renata7zemanova/Semafor/text/text/zkratky.tex

\cleardoublepage
\chapter*{\listofabbrevname}
\phantomsection
\addcontentsline{toc}{chapter}{\listofabbrevname}

\begin{acronym}[KolikMista]

	\acro{AD}{Analog to Digital - analogově-digitální}
	\acro{dB}{decibel - jednotka intenzity zvuku}
	\acro{DPS}{Deska plošného spoje}
	\acro{EMC}{Elektromagnetická kompatibilita}
	\acro{FDM}{Fused deposition modeling -  metoda 3D tisku pomocí taveného nanášení}
	\acro{GND}{Ground - nulový potenciál}
	\acro{GPIO}{General Purpose Input/Output - vstupně-výstupní piny}
	\acro{HTML}{Hyper Text Markup Language - hypertextový znakovací jazyk, který se používá pro vytváření webových stránek}
	\acro{IoT}{Internet of Things - internet věcí}
	\acro{IP}{Internet Protocol - internetový protokol}
	\acro{$I^2C$}{Inter-Integrated Circuit - multi-masterová sériová komunikační sběrnice}
	\acro{LED}{Light-Emitting Diode - dioda emitující světlo}
	\acro{LoRa}{Long Range Radio}
	\acro{LoRaWAN}{Long Range Wide Area Network}
	\acro{MCU}{Mikrokontrolér}
	\acro{NFC}{Near Field Communication - typ bezdrátové komunikace}
	\acro{PETG}{Polyethylentereftalát-glykol - materiál pro 3D tisk}
	\acro{RF}{Rádiová frekvence}
	\acro{ROM}{Read-Only Memory - typ elektronické paměti}
	\acro{SLA}{Stereolitografie - metoda 3D tisku}
	\acro{SPI}{Serial Peripheral Interface - sériové komunikační periferní rozhraní}
	\acro{UART}{Universal asynchronous receiver-transmitter - komunikační sběrnice}
	\acro{USB}{Universal Serial Bus - univerzální komunikační sériová sběrnice}
	\acro{WiFi}{Wireless Fidelity}

	%\acro{zkDummy}
	%	[KolikMista]
	%	{pouze ukázka vyhrazeného místa}

	%\acro{symfvz}						% název
	%	[\ensuremath{f_\textind{vz}}] % symbol
	%	{vzorkovací kmitočet}					% popis

\end{acronym}
