renata7zemanova/Semafor/text/sablona-obhaj.pdf

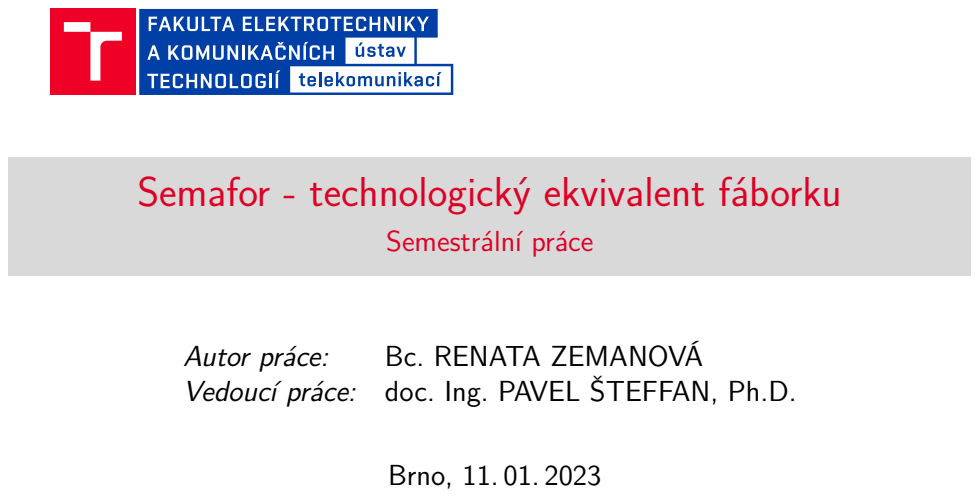
[picture p62: page 1]
Semestrální práce; Autor práce:; Bc. RENATA ZEMANOVÁ; Brno, 11. 01. 2023

Semafor - technologický ekvivalent fáborku

Vedoucí práce: doc. Ing. PAVEL ŠTEFFAN, Ph.D.

## Základní informace

Co je to Semafor?
Outdoorová aplikace
Edukační účely, táborové hry Zástupná funkce organizátora Dotykové senzory
Světelné a zvukové signalizace

Požadavky:
Kompaktnost
Bezpečnost
Široké využití

Voděodolnost
Nízkou cenu
Jednoduchost
Možnost komunikace mezi
jednotlivými Semafory
Bezdrátová konfigurovatelnost
Bc. Renata Zemanová | Semafor - technologický ekvivalent fáborku | 1 / 8

## Cíle práce

Nastudovat
Porovnat
Vybrat
Navrhnout


Bc. Renata Zemanová | Semafor - technologický ekvivalent fáborku | 2 / 8

## Základní prvky

Bezdrátová komunikace
LoRa
Dosah až 20 km
Bezlicenční pásmo
Topologie hvězdy
Obousměrná komunikace
WiFi
Bezlicenční pásmo
Rozšířená
V každém mobilním telefonu

Mikrokontrolér
ESP32-C3-MINI-1
WiFi s anténou
SPI, UART, I

2C, USB

13 GPIO pinů

Bc. Renata Zemanová | Semafor - technologický ekvivalent fáborku | 3 / 8

## Napájení

Baterie LiFePO4
3 až 3,6 V
Nejbezpečnější
Životnost až 7000 cyklů
Teplotně stabilní
Nehořlavé
Netoxické
Nabíjecí obvod CN3058E
Určený pro LiFePO4
Nastavitelný nabíjecí
proud
Signalizace stavu
nabíjení
Měření napětí na baterii

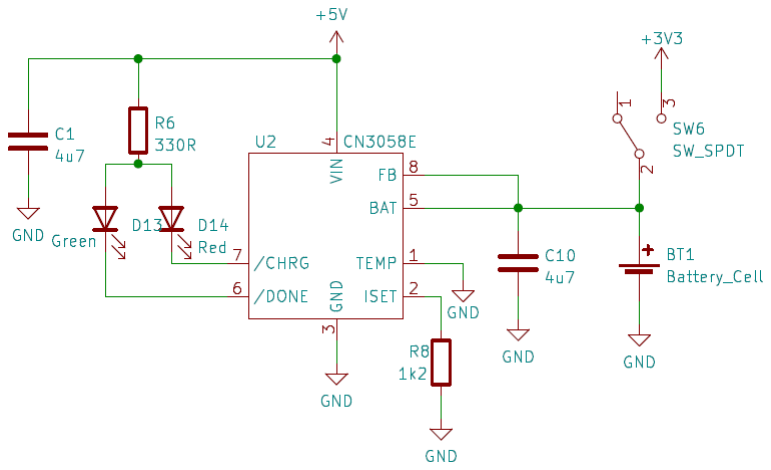
[picture p63: figure]

Bc. Renata Zemanová | Semafor - technologický ekvivalent fáborku | 4 / 8

## Komunikace s okolím

Světelná signalizace
Programovatelné LED WS2812C Možnost spojení za sebou
Převodník úrovní
Zvyšovač napětí LT1930

Senzory doteku
Kapacitní tlačítka
Mechanická odolnost
Životnost

Převodník
Komunikace po I

2C
Až 7 tlačítek

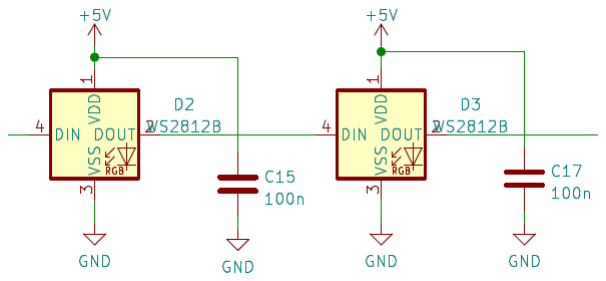
[picture p64: figure]

Bc. Renata Zemanová | Semafor - technologický ekvivalent fáborku | 5 / 8

## Budoucnost

Návrh DPS
Výroba a oživení DPS
Vytvoření her
Webová stránka pro konfiguraci
Bc. Renata Zemanová | Semafor - technologický ekvivalent fáborku | 6 / 8

## Závěr

Bezdrátový modul
Mikrokontrolér
Napájení
Senzory doteku
Signalizační prvky
Návrh kompletní
elektroniky

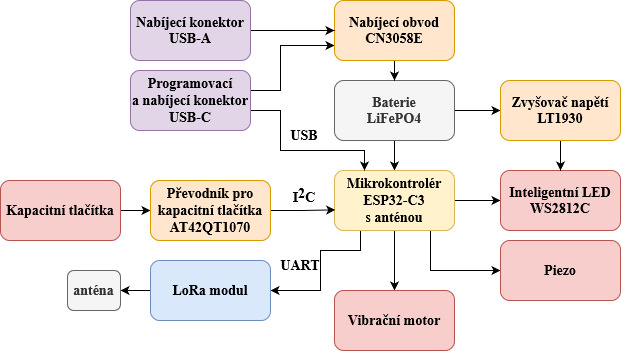
[picture p65: figure]

Bc. Renata Zemanová | Semafor - technologický ekvivalent fáborku | 7 / 8

# Děkuji za

# pozornost!

Bezdrátový modul
Mikrokontrolér
Napájení
Senzory doteku
Signalizační prvky
Návrh kompletní
elektroniky
Bc. Renata Zemanová | Semafor - technologický ekvivalent fáborku | 8 / 8
