renata7zemanova/Semafor/text/obrazky/tlacitka_princip.png

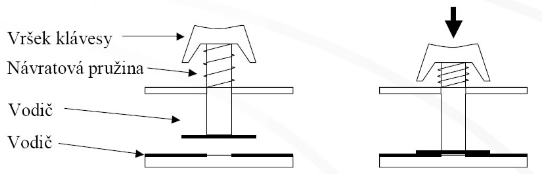
text/obrazky/tlacitka_princip.png
