renata7zemanova/Semafor/text/obrazky/vysledne_blokove_schema_priloha.jpg

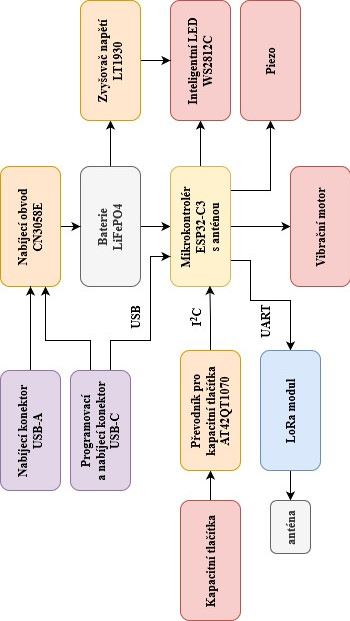
text/obrazky/vysledne_blokove_schema_priloha.jpg
