renata7zemanova/Semafor/forma_na_silikon/Semafor2_kompletni.SLDASM

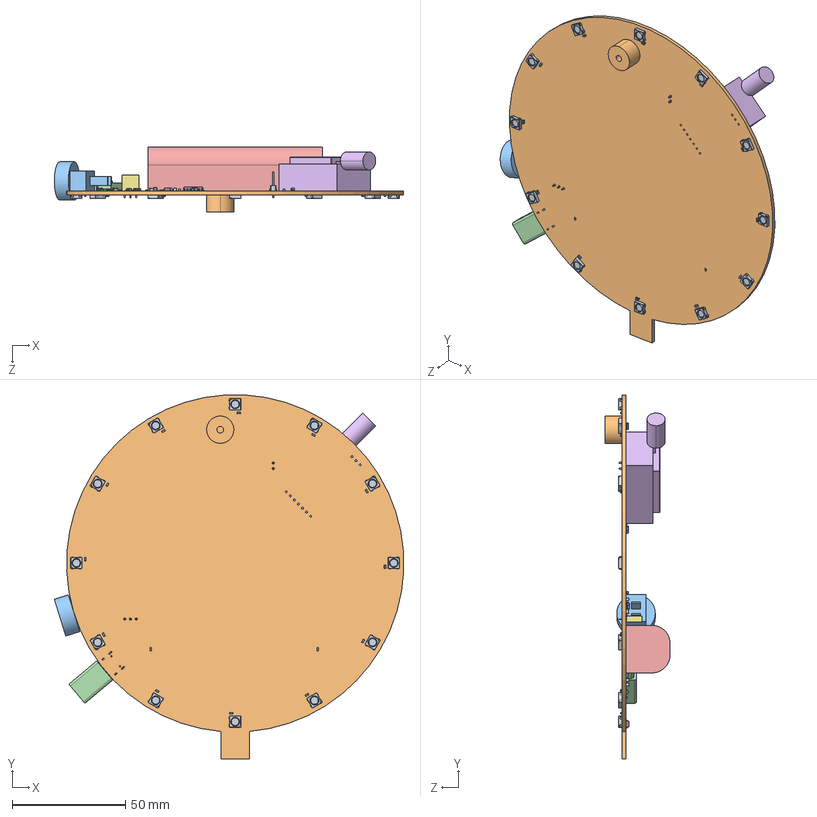
[picture p68: CAD file, 2023-05-05]
forma_na_silikon/Semafor2_kompletni.SLDASM
154.1 x 160.5 x 28.8 mm
SOLID.step x 12
SOLID-0.step
SOLID-1.step x 15
SOLID-2.step x 23
SOLID-3.step x 5
SOLID-4.step
SOLID-5.step
SOLID-6.step x 4
SOLID-7.step x 7
SOLID-8.step x 4
SOLID-9.step x 4
SOLID-10.step
SOLID-11.step
SOLID-12.step
SOLID-13.step x 2
SOLID-14.step
SOLID-15.step
Semafor PCB.step
Button
USB_cable
