renata7zemanova/Semafor/forma_na_silikon/Sestava_forma_Semafor_2.SLDASM

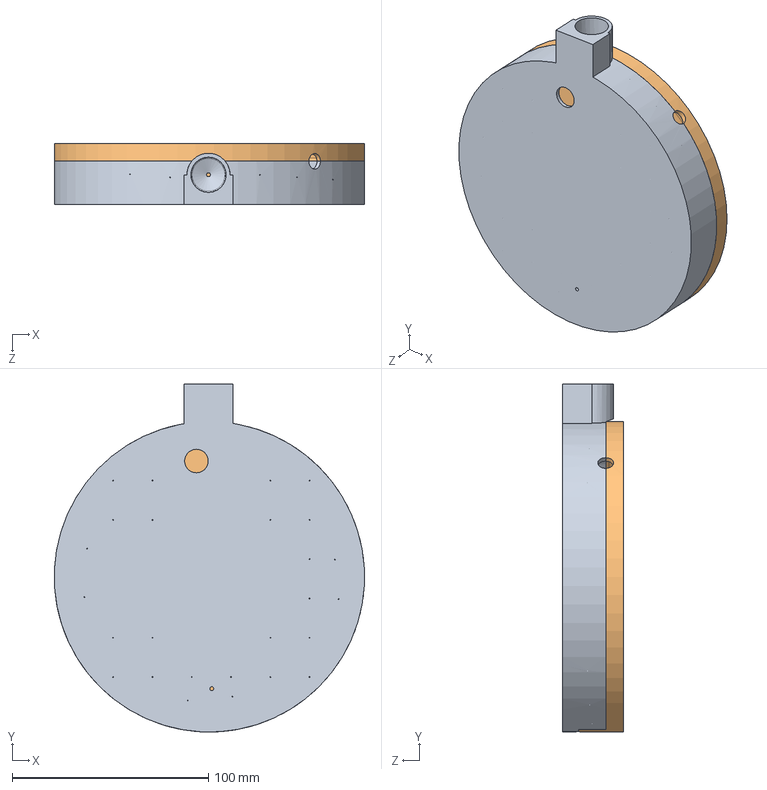
[picture p69: CAD file, 2023-05-05]
forma_na_silikon/Sestava_forma_Semafor_2.SLDASM
157.9 x 177.1 x 31.0 mm
Pulka_top_Semafor2
Pulka_bottom_Semafor2
