renata7zemanova/Semafor/forma_na_silikon/Semafor.SLDASM

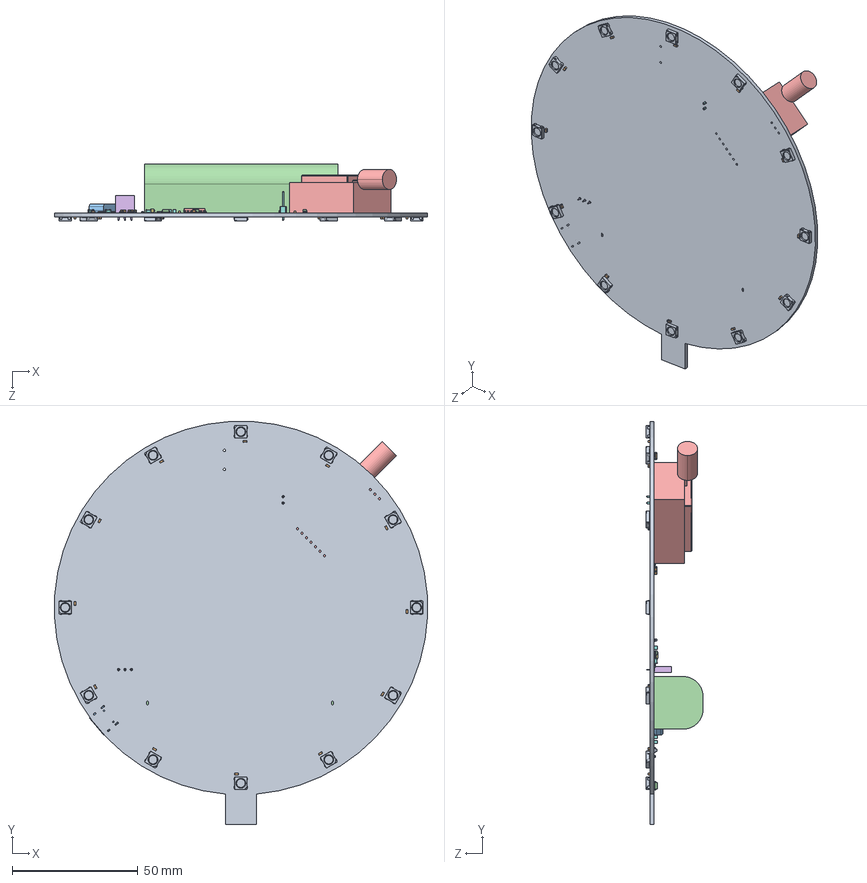
[picture p72: CAD file, 2023-05-05]
forma_na_silikon/Semafor.SLDASM
148.6 x 160.5 x 22.8 mm
SOLID.step x 12
SOLID-0.step x 15
SOLID-1.step x 23
SOLID-2.step x 5
SOLID-3.step
SOLID-4.step
SOLID-5.step x 4
SOLID-6.step x 7
SOLID-7.step x 4
SOLID-8.step x 4
SOLID-9.step
SOLID-10.step
SOLID-11.step
SOLID-12.step x 2
SOLID-13.step
SOLID-14.step
Semafor PCB.step
