renata7zemanova/Semafor/forma_na_silikon/Semafor2_s_obalem.SLDASM

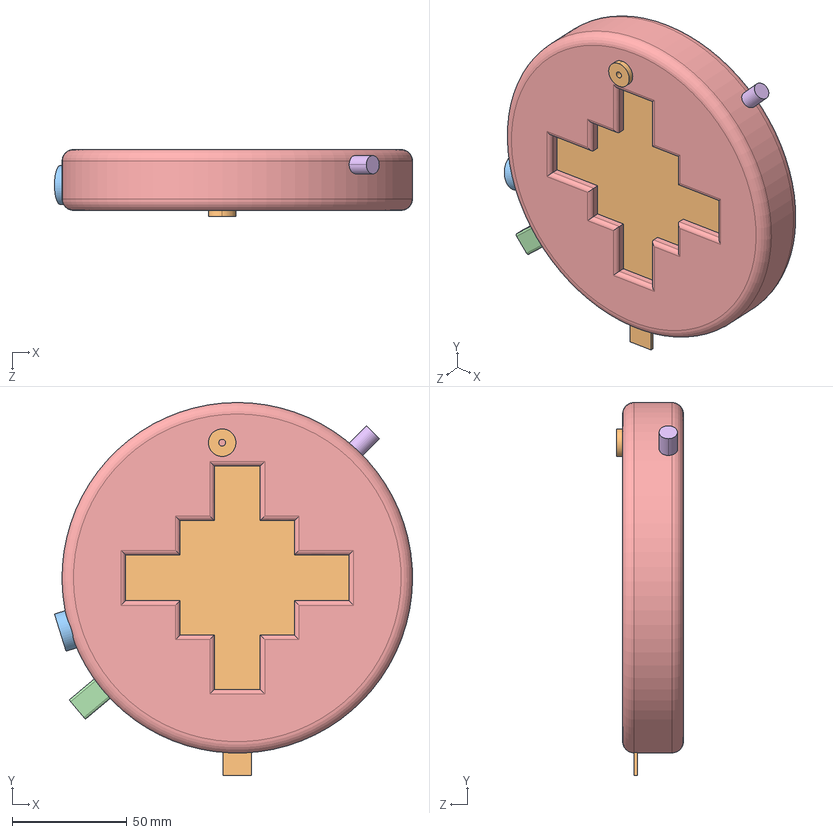
[picture p73: CAD file, 2023-05-05]
forma_na_silikon/Semafor2_s_obalem.SLDASM
156.3 x 162.8 x 29.2 mm
SOLID.step x 12
SOLID-0.step
SOLID-1.step x 15
SOLID-2.step x 23
SOLID-3.step x 5
SOLID-4.step
SOLID-5.step
SOLID-6.step x 4
SOLID-7.step x 7
SOLID-8.step x 4
SOLID-9.step x 4
SOLID-10.step
SOLID-11.step
SOLID-12.step
SOLID-13.step x 2
SOLID-14.step
SOLID-15.step
Semafor PCB.step
Button
USB_cable
Obal
