renata7zemanova/Semafor/forma_na_silikon/Forma_sestava.SLDASM

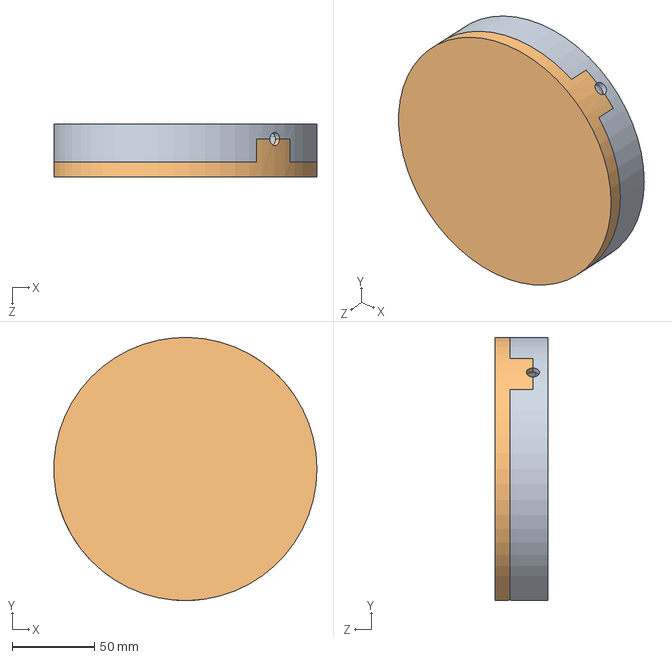
[picture p74: CAD file, 2023-05-05]
forma_na_silikon/Forma_sestava.SLDASM
159.9 x 159.9 x 32.0 mm
Pulka1
Pulka2
