renata7zemanova/Semafor/forma_na_silikon/Pulka_top_Semafor2.SLDPRT

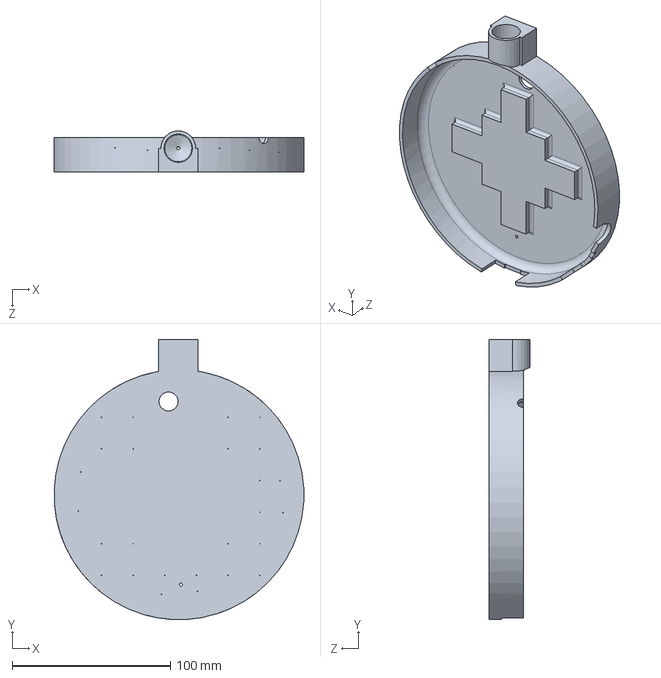
[picture p76: CAD file, 2023-05-05]
forma_na_silikon/Pulka_top_Semafor2.SLDPRT
157.8 x 177.0 x 26.0 mm
