renata7zemanova/Semafor/forma_na_silikon/soucastky/Vypinac.STEP

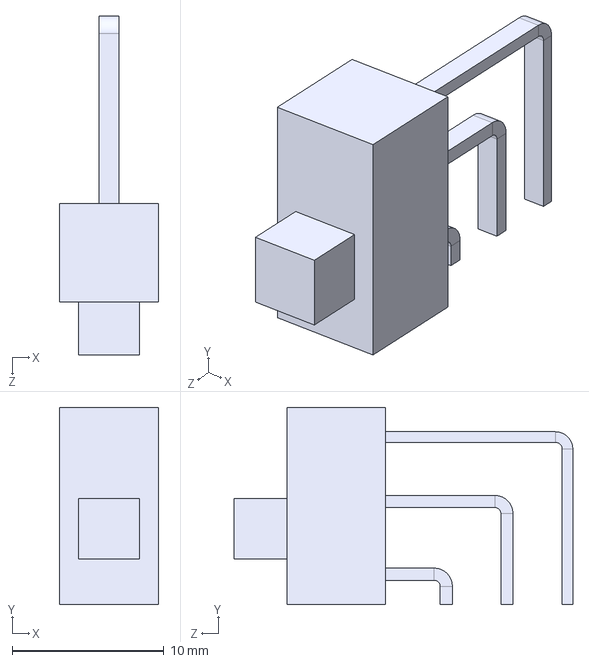
[picture p77: CAD file, 2023-05-07]
forma_na_silikon/soucastky/Vypinac.STEP
6.50 x 13.0 x 22.4 mm
