renata7zemanova/Semafor/obal/Krabicka_3D_tisk.SLDPRT

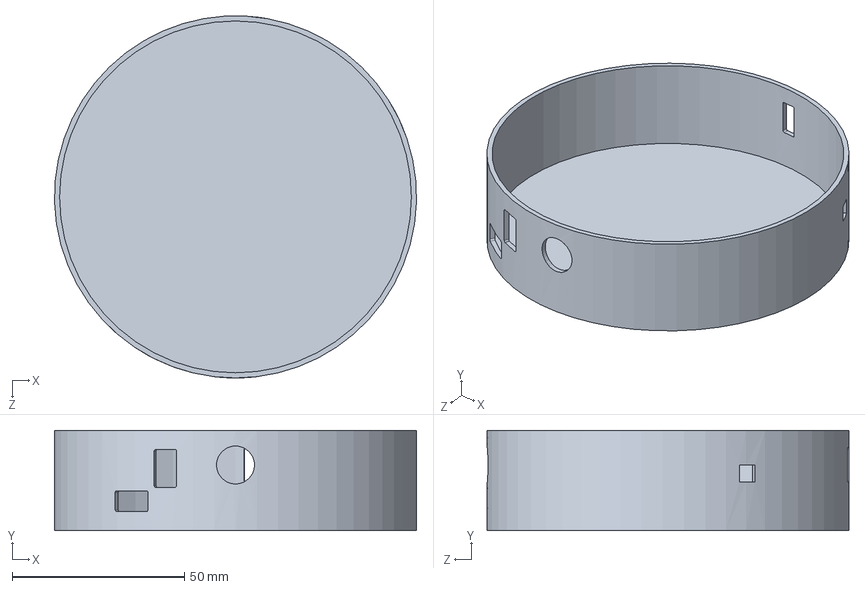
[picture p78: CAD file, 2023-05-15]
obal/Krabicka_3D_tisk.SLDPRT
105.0 x 29.0 x 104.9 mm
