renata7zemanova/Semafor/forma_na_silikon/Pulka2.SLDPRT

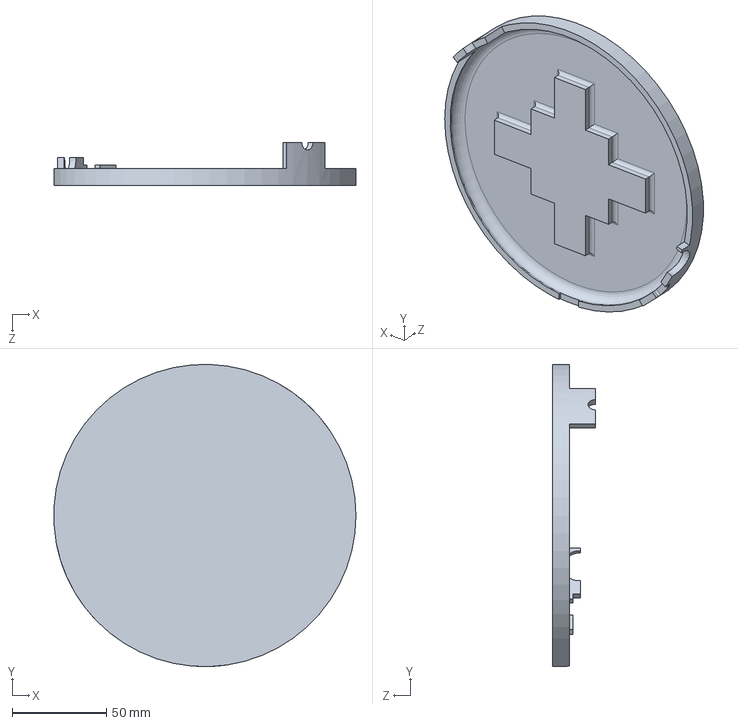
[picture p79: CAD file, 2023-05-05]
forma_na_silikon/Pulka2.SLDPRT
159.9 x 159.9 x 23.0 mm
