renata7zemanova/Semafor/forma_na_silikon/soucastky/Pinheady_dlouhe.STEP

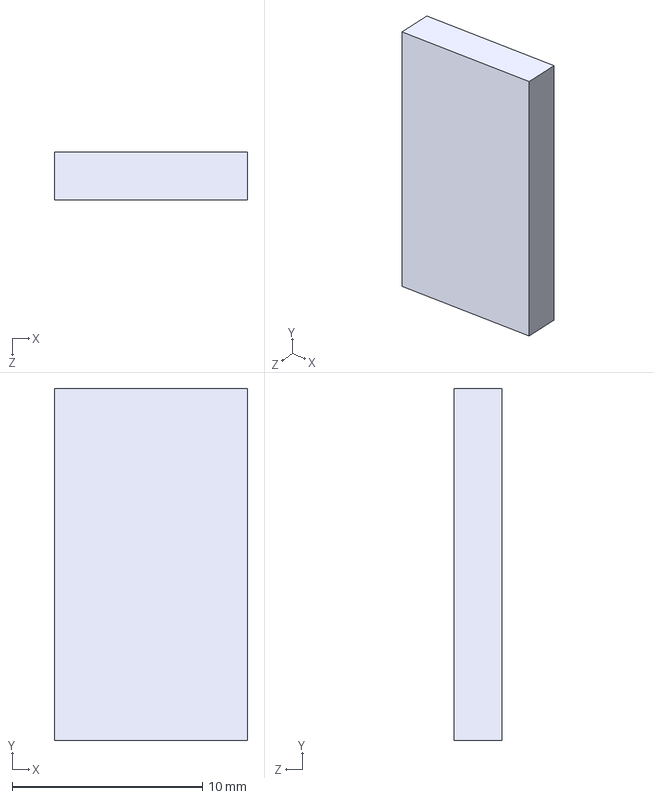
[picture p80: CAD file, 2023-05-05]
forma_na_silikon/soucastky/Pinheady_dlouhe.STEP
10.2 x 18.5 x 2.54 mm
