renata7zemanova/Semafor/obal/Na_tyblo.SLDPRT

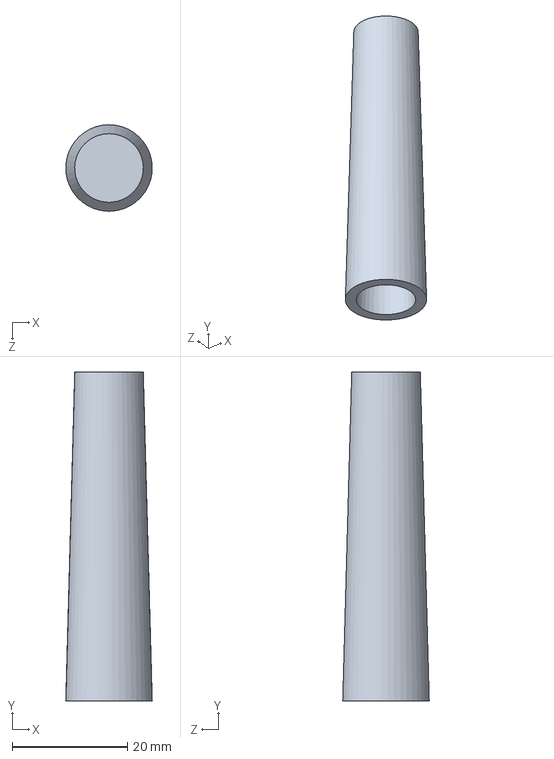
[picture p81: CAD file, 2023-05-15]
obal/Na_tyblo.SLDPRT
15.0 x 57.0 x 15.0 mm
