renata7zemanova/Semafor/forma_na_silikon/soucastky/USB_cable.SLDPRT

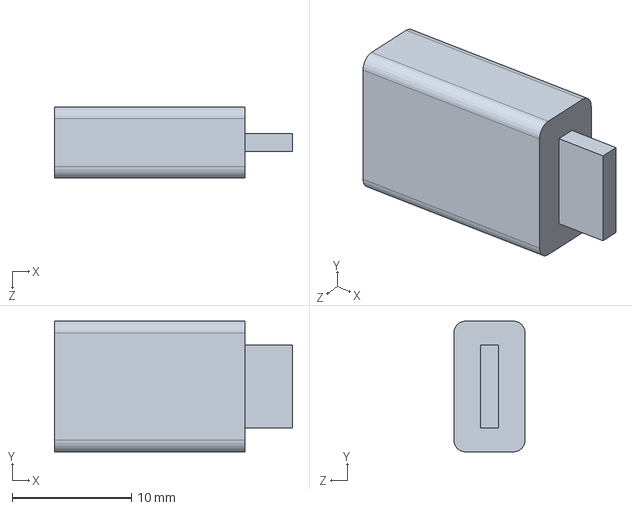
[picture p82: CAD file, 2023-05-05]
forma_na_silikon/soucastky/USB_cable.SLDPRT
20.0 x 11.0 x 6.00 mm
