renata7zemanova/Semafor/forma_na_silikon/Semafor_s_obalem_soucastka.SLDPRT

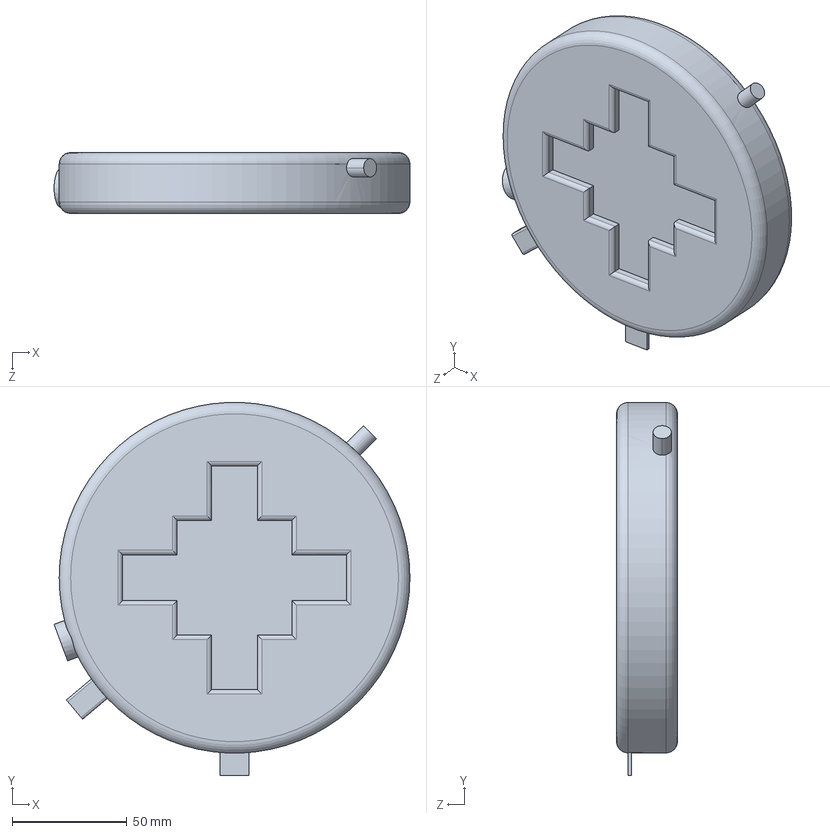
[picture p83: CAD file, 2023-05-05]
forma_na_silikon/Semafor_s_obalem_soucastka.SLDPRT
155.2 x 162.7 x 26.6 mm
