renata7zemanova/Semafor/forma_na_silikon/soucastky/Battery_pack.STEP

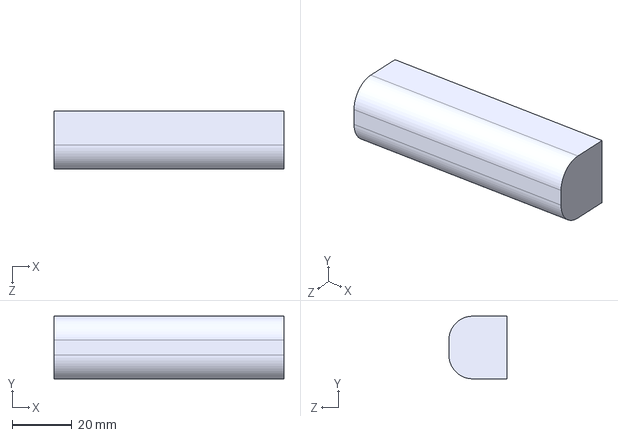
[picture p84: CAD file, 2023-05-05]
forma_na_silikon/soucastky/Battery_pack.STEP
77.0 x 21.0 x 19.5 mm
