renata7zemanova/Semafor/forma_na_silikon/Pulka_bottom_Semafor2.SLDPRT

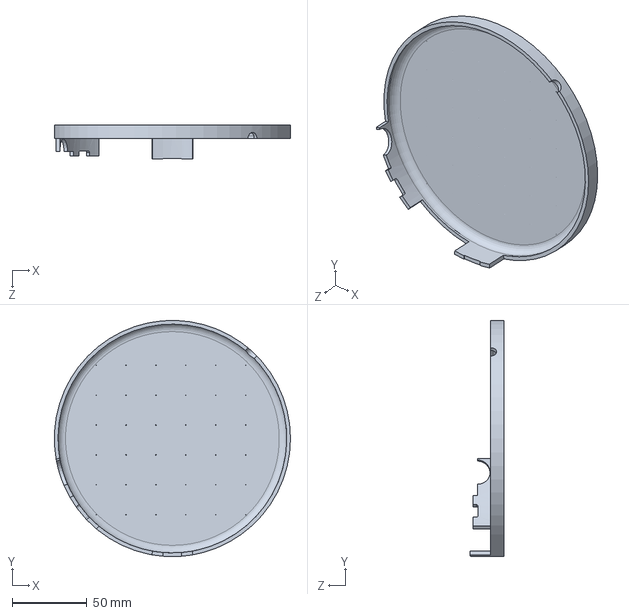
[picture p85: CAD file, 2023-05-05]
forma_na_silikon/Pulka_bottom_Semafor2.SLDPRT
157.9 x 157.9 x 23.0 mm
