renata7zemanova/Semafor/forma_na_silikon/soucastky/Button.SLDPRT

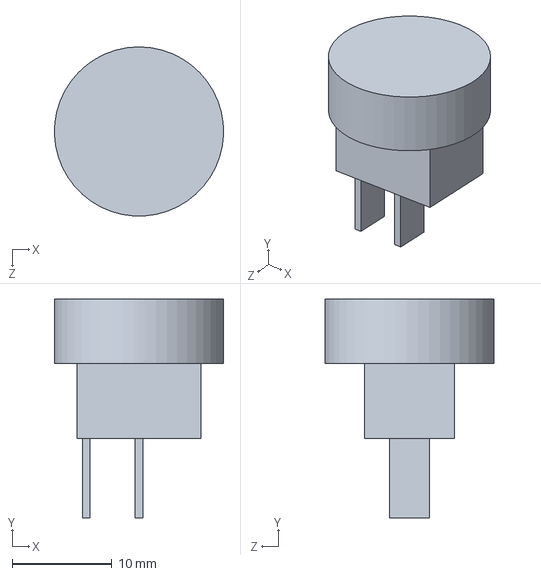
[picture p86: CAD file, 2023-05-05]
forma_na_silikon/soucastky/Button.SLDPRT
17.0 x 22.0 x 17.0 mm
