renata7zemanova/Semafor/forma_na_silikon/soucastky/E22_900T22D.STEP

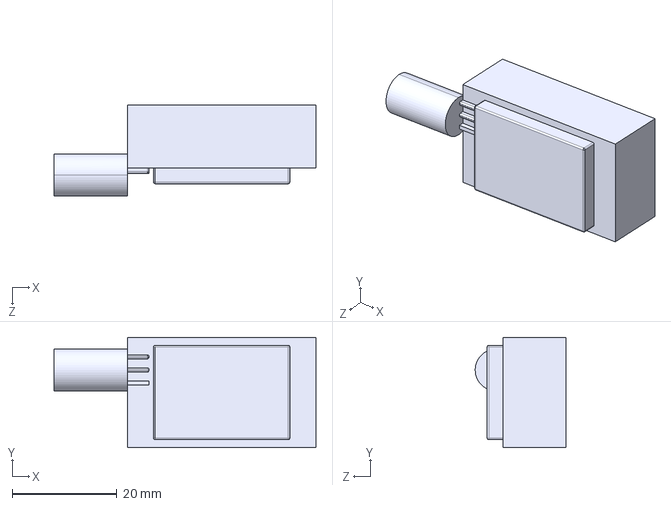
[picture p87: CAD file, 2023-05-05]
forma_na_silikon/soucastky/E22_900T22D.STEP
50.0 x 21.0 x 17.3 mm
