renata7zemanova/Semafor/forma_na_silikon/soucastky/USB_C.STEP

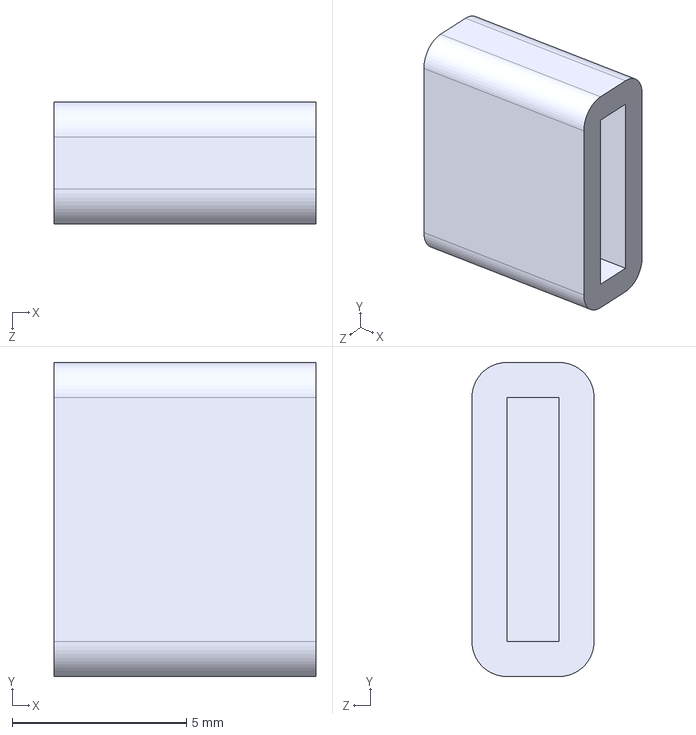
[picture p88: CAD file, 2023-05-05]
forma_na_silikon/soucastky/USB_C.STEP
7.50 x 9.00 x 3.50 mm
