renata7zemanova/Semafor/forma_na_silikon/Obal.SLDPRT

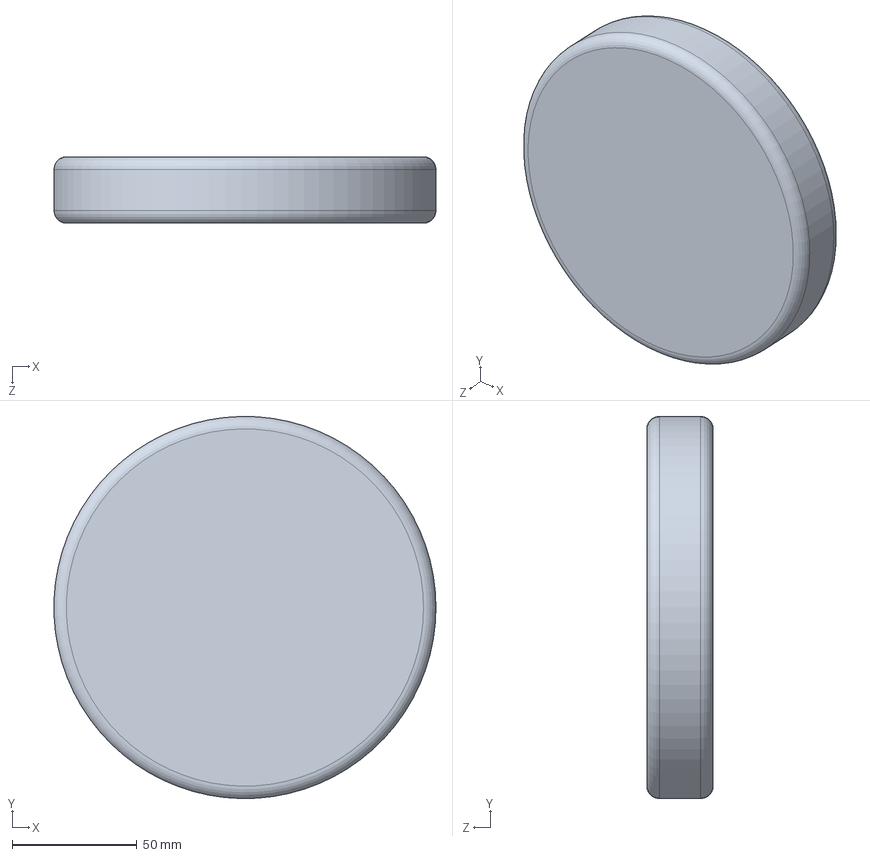
[picture p89: CAD file, 2023-05-05]
forma_na_silikon/Obal.SLDPRT
152.9 x 153.0 x 26.6 mm
