renata7zemanova/Semafor/forma_na_silikon/Celkova_forma_Semafor_2.SLDPRT

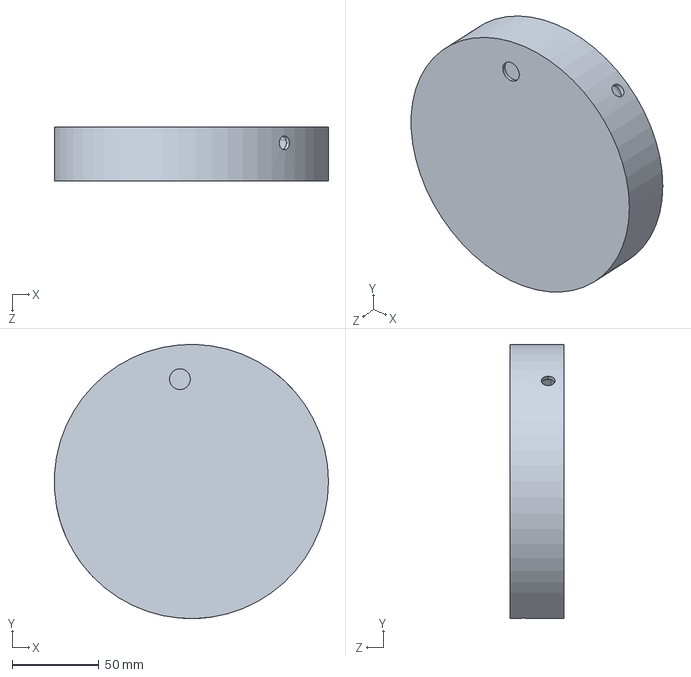
[picture p90: CAD file, 2023-05-05]
forma_na_silikon/Celkova_forma_Semafor_2.SLDPRT
157.9 x 157.9 x 31.0 mm
