renata7zemanova/Semafor/forma_na_silikon/Zaklad_formy.SLDPRT

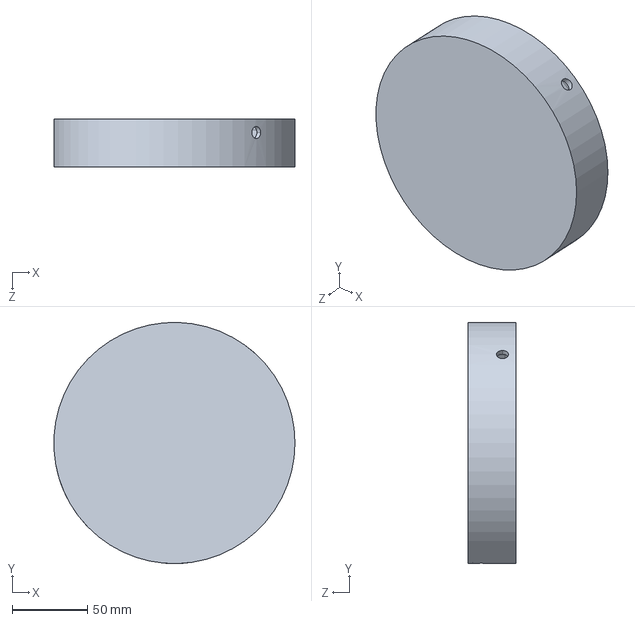
[picture p91: CAD file, 2023-05-05]
forma_na_silikon/Zaklad_formy.SLDPRT
159.9 x 159.9 x 32.0 mm
