renata7zemanova/Semafor/forma_na_silikon/Pulka1.SLDPRT

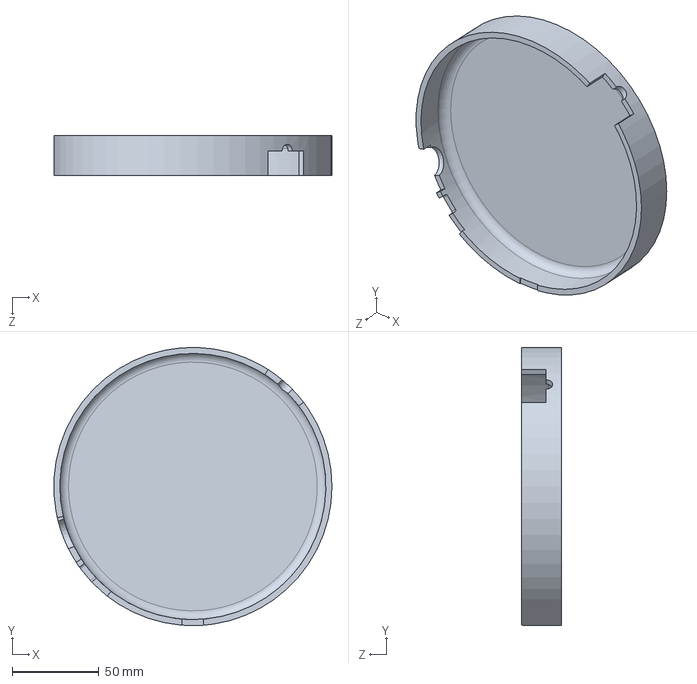
[picture p92: CAD file, 2023-05-05]
forma_na_silikon/Pulka1.SLDPRT
159.9 x 159.9 x 23.0 mm
