renata7zemanova/Semafor/(list of files, cad)

Other CAD files:
forma_na_silikon/Pulka_bottom_Semafor2.STL
forma_na_silikon/Pulka_top_Semafor2.STL
forma_na_silikon/soucastky/Battery_pack.SLDPRT
forma_na_silikon/soucastky/E22_900T22D.SLDPRT
forma_na_silikon/soucastky/Piezo.SLDPRT
forma_na_silikon/soucastky/Pinheady_dlouhe.SLDPRT
forma_na_silikon/soucastky/USB_C.SLDPRT
forma_na_silikon/soucastky/Vypinac.SLDPRT
obal/Krabicka_3D_tisk.3MF
obal/Krabicka_3D_tisk.STL
obal/Na_tyblo.3MF
obal/Na_tyblo.STL
