renata7zemanova/Semafor/text/prilohy/schema_zapojeni.pdf

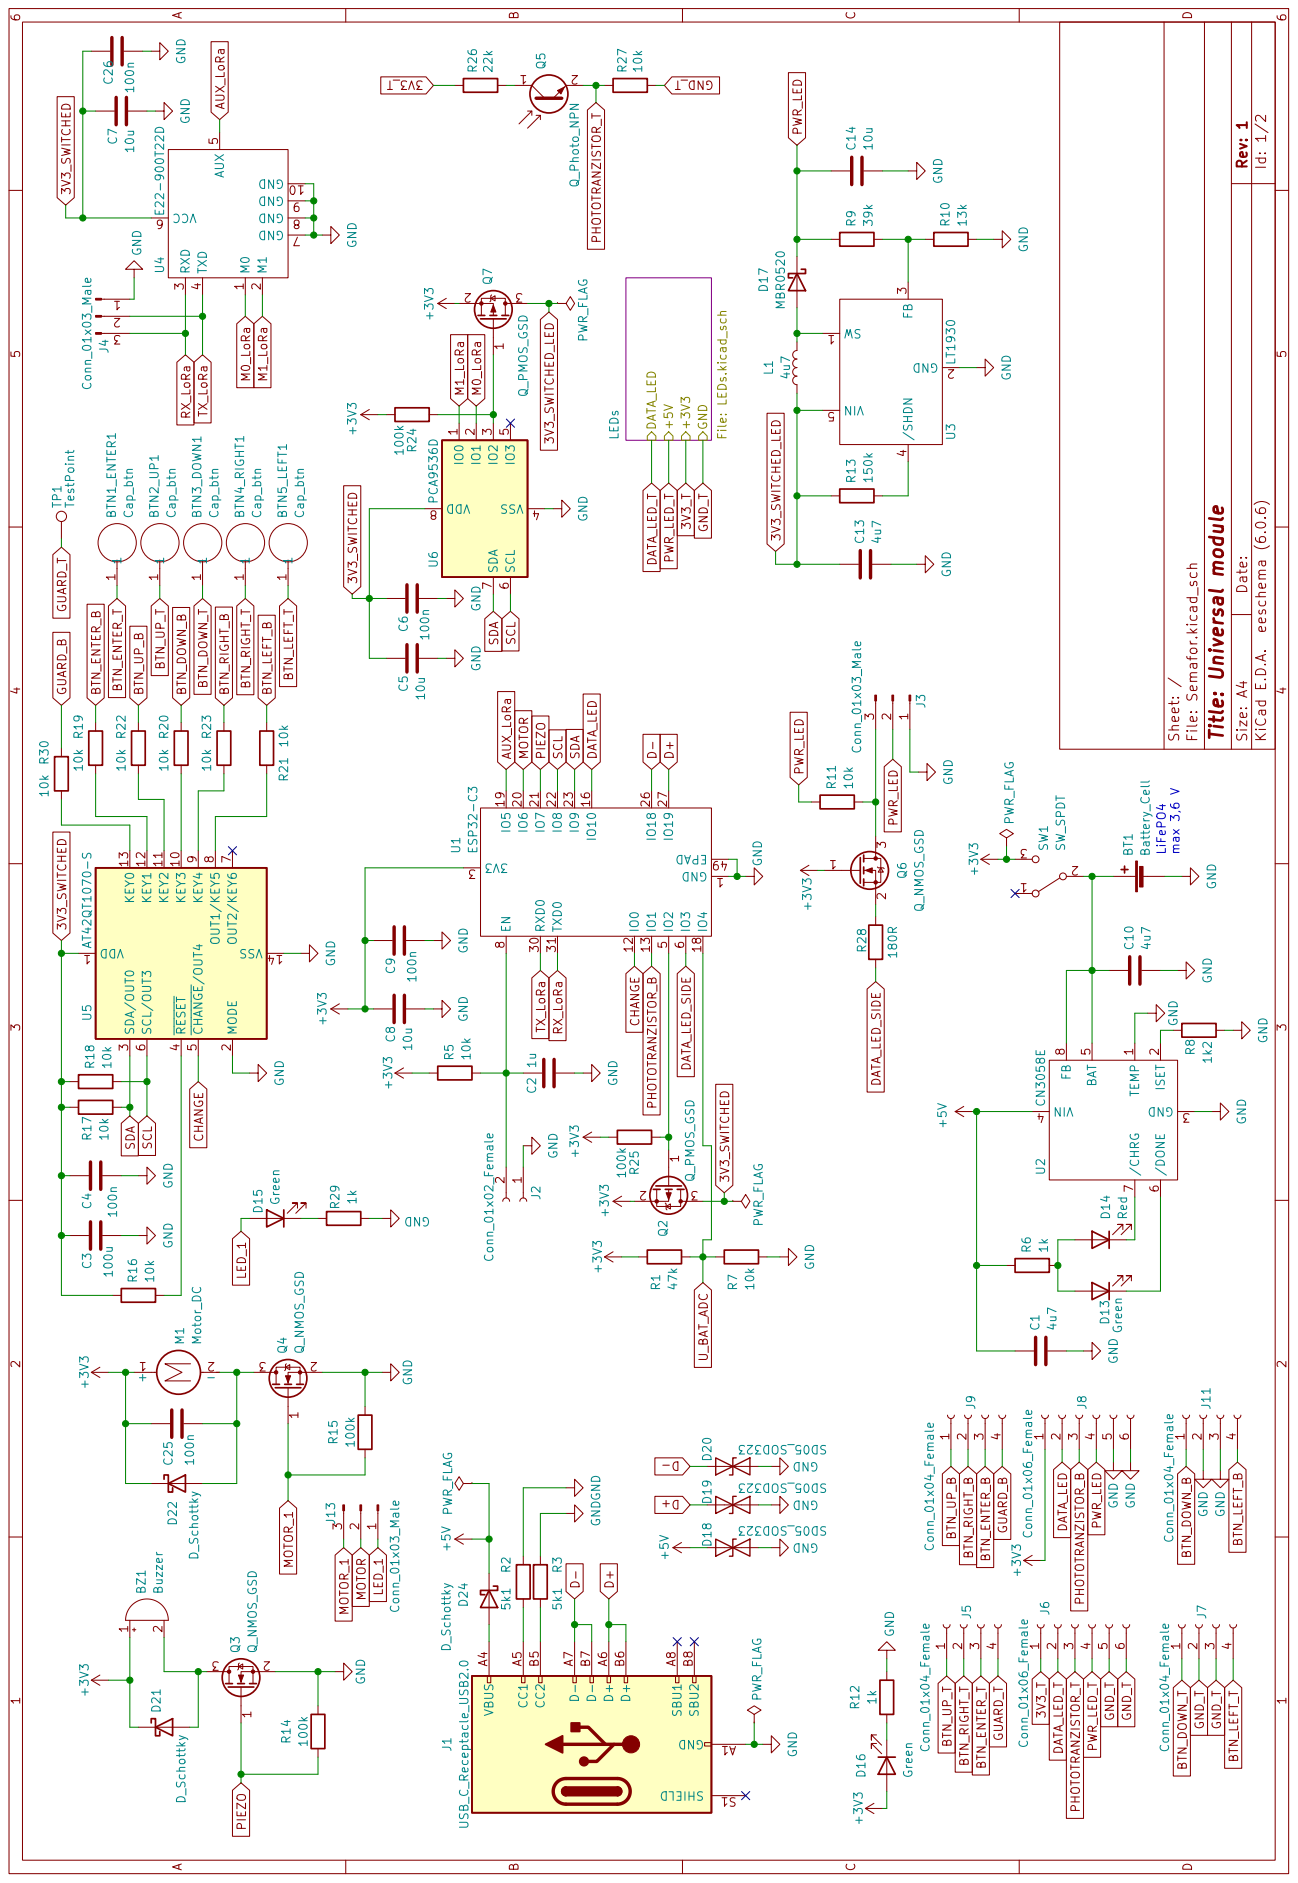
[picture p93: page 1]

D Date: KiCad E.D.A. eeschema (6.0.6) Rev: 1 Size: A4

Id: 1/2 Sheet: / File: Semafor.kicad_sch

LEDs File: LEDs.kicad_sch GND GND GND

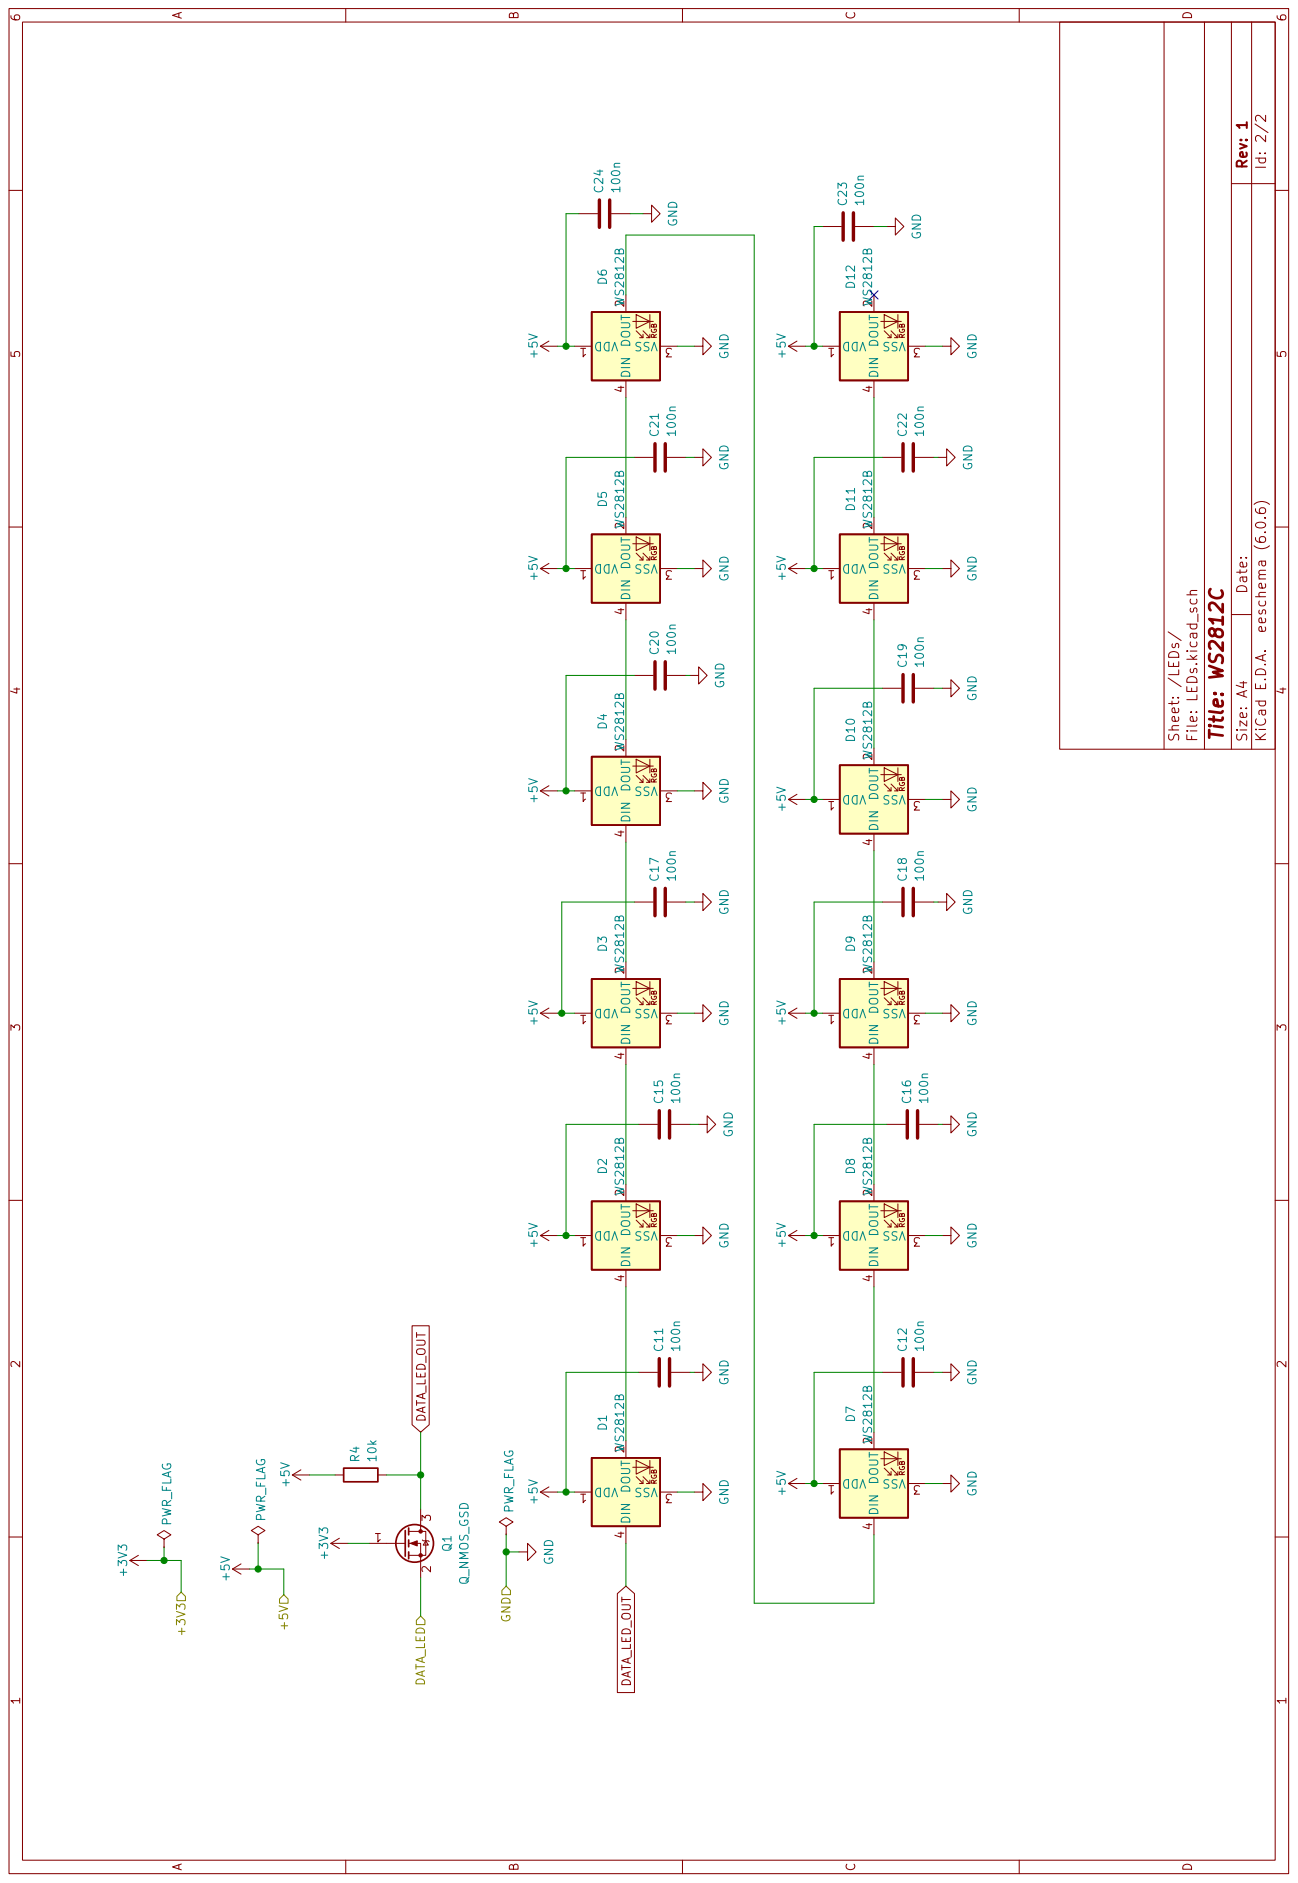
[picture p94: page 2]

D Date: KiCad E.D.A. eeschema (6.0.6) Rev: 1 Size: A4

Id: 2/2 Sheet: /LEDs/ File: LEDs.kicad_sch

100n GND GND GND VDD RGB 1 DOUT

4 D2 WS2812B GND GNDVDD RGB 1 DOUT

+5V GND VDD RGB 1 DOUT

100n GND VDD RGB 1 DOUT

4 D10 WS2812B GND VDD RGB 1 DOUT
