renata7zemanova/Semafor/text/prilohy/KiCad_PCB.pdf

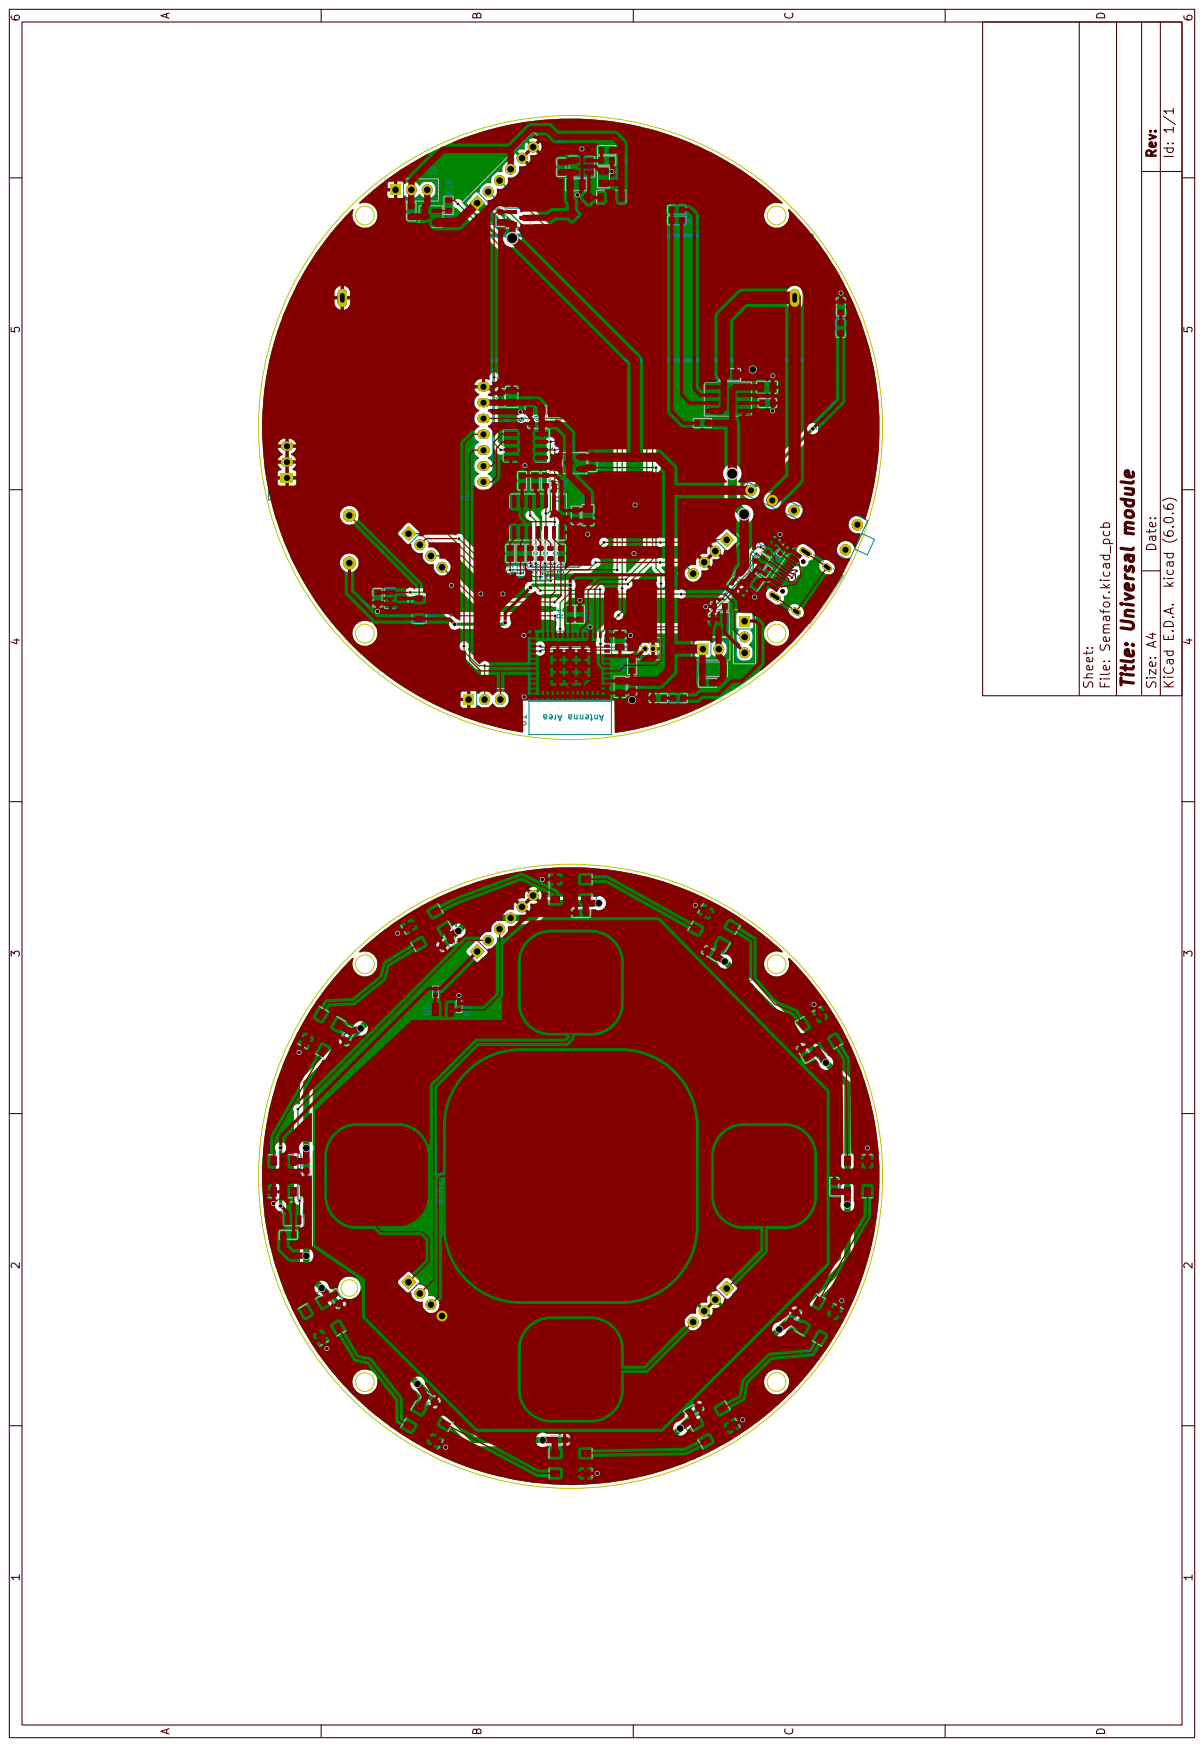
[picture p95: page 1]
