renata7zemanova/Semafor/HW/Semafor.kicad_pcb

## KiCad design HW/Semafor.kicad_pcb (2023-05-16)

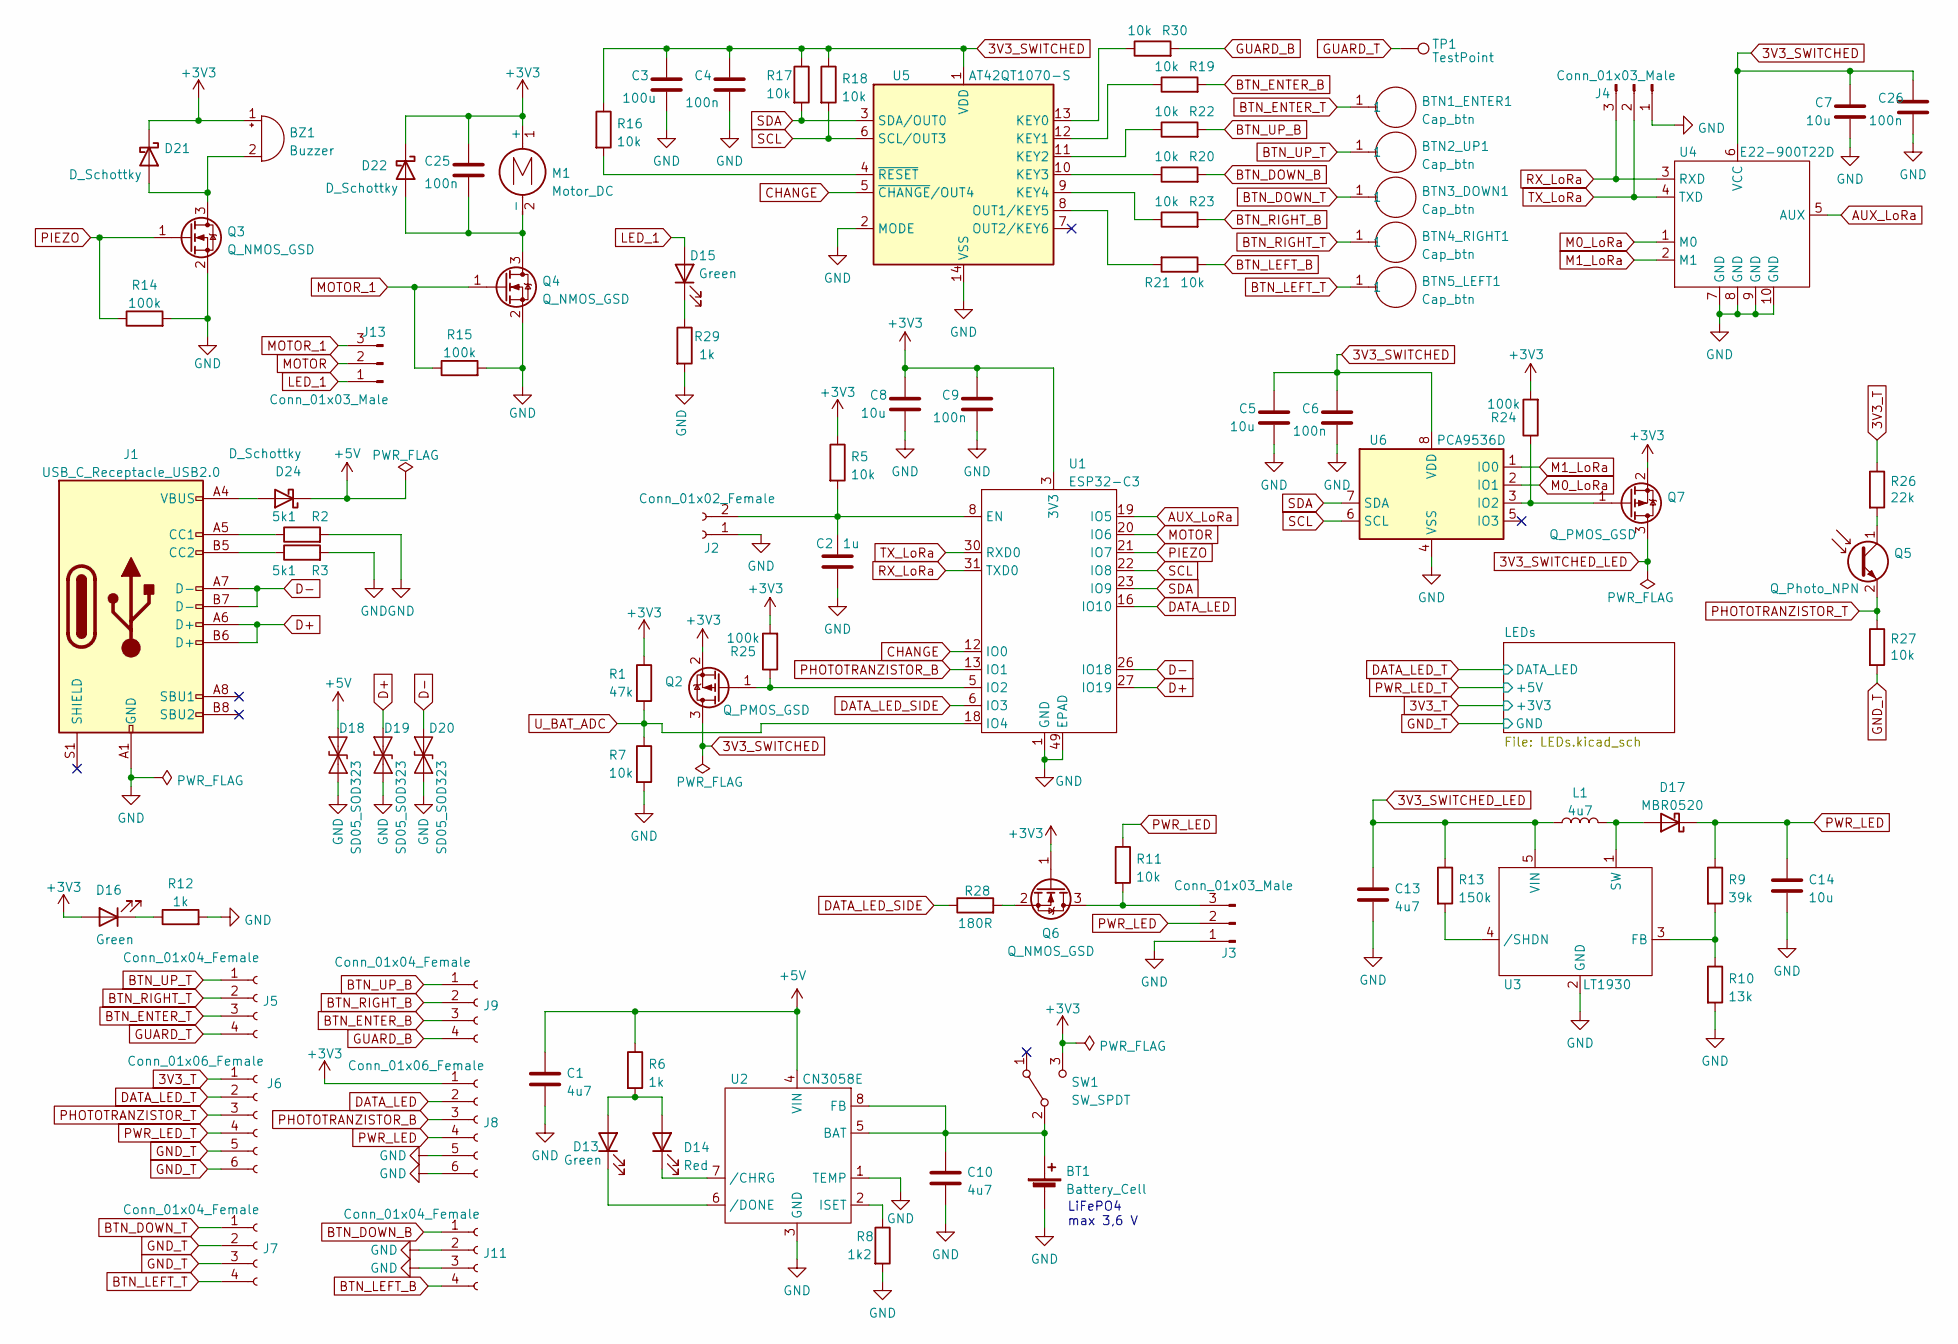
[picture p96: schematic Semafor.kicad_sch, Universal module]

Parts:
BT1: Battery_Cell; battery_dock; LCSC ručně
BTN1_ENTER1: Cap_btn; Cap_btn_4x4
BTN2_UP1, BTN3_DOWN1, BTN4_RIGHT1, BTN5_LEFT1: Cap_btn; Cap_btn_1,6x1,6
BZ1: Buzzer; PIEZO; LCSC ručně
C1, C10, C13: 4u7; C_0805_2012Metric; LCSC C1779
C2: 1u; C_0805_2012Metric; LCSC C28323
C3: 100u; C_0805_2012Metric; LCSC ručně
C4, C6, C9, C25, C26: 100n; C_0603_1608Metric; LCSC C14663
C5, C7, C8, C14: 10u; C_0805_2012Metric; LCSC C15850
D13, D15, D16: Green; LED_0603_1608Metric; LCSC C965805
D14: Red; LED_0603_1608Metric; LCSC C965799
D17: MBR0520; D_SOD-123; LCSC C77335
D18, D19, D20: SD05_SOD323; D_SOD-323; LCSC C3002993
D21, D22, D24: D_Schottky; D_SOD-123; LCSC C2909923
J1: USB_C_Receptacle_USB2.0; USB_C_Receptacle_HRO_TYPE-C-31-M-12; LCSC C136423
J2: Conn_01x02_Female; PinSocket_1x02_P1.27mm_Vertical; LCSC ručně
J3, J4, J13: Conn_01x03_Male; PinSocket_1x03_P2.54mm_Vertical; LCSC ručně
J5, J7, J9, J11: Conn_01x04_Female; PinHeader_1x04_P2.54mm_Vertical; LCSC ručně
J6, J8: Conn_01x06_Female; PinSocket_1x06_P2.54mm_Vertical; LCSC ručně
L1: 4u7; L_CDRH3D18; LCSC C167273
M1: Motor_DC; PinHeader_1x02_P2.54mm_Vertical; LCSC C2891560
Q2, Q7: Q_PMOS_GSD; SOT-23; LCSC C10487
Q3, Q4, Q6: Q_NMOS_GSD; SOT-23; LCSC C8545
Q5: Q_Photo_NPN; SMD,3.5x2.8x1.9mm; JLCPCB_CORRECTION 0;0;0
R1: 47k; R_0603_1608Metric; LCSC C25819
R2, R3: 5k1; R_0402_1005Metric; LCSC C25905
R5, R7, R11, R16, R17, R18, R19, R20, R21, R22, R23, R30: 10k; R_0603_1608Metric; LCSC C25804
R6, R12, R29: 1k; R_0603_1608Metric; LCSC C21190
R8: 1k2; R_0603_1608Metric; LCSC C22765
R9: 39k; R_0603_1608Metric; LCSC C23153
R10: 13k; R_0603_1608Metric; LCSC C22797
R13: 150k; R_0603_1608Metric; LCSC C22807
R14, R15, R24, R25: 100k; R_0603_1608Metric; LCSC C25803
R26: 22k; R_0402_1005Metric; JLCPCB_CORRECTION 0;0;0
R27: 10k; R_0402_1005Metric; JLCPCB_CORRECTION 0;0;0
R28: 180R; R_0603_1608Metric; LCSC C22828
SW1: SW_SPDT; BTN_1101M2S2AV2QE2; LCSC C221537
TP1: TestPoint; TestPoint_Pad_D2.0mm
U1: ESP32-C3; LCSC C2838502
U2: CN3058E; SOP-8_3.76x4.96mm_P1.27mm; LCSC C112011
U3: LT1930; SOT-23-5; LCSC C579930
U4: E22-900T22D; LCSC ručně
U5: AT42QT1070-S; SOIC-14_3.9x8.7mm_P1.27mm; LCSC ručně
U6: PCA9536D; SOIC-8_3.9x4.9mm_P1.27mm; LCSC C129522

Connections:
3V3_SWITCHED: C3.1, C4.1, C5.1, C6.1, C7.1, C26.1, Q2.3 (D), R16.1, R17.1, R18.1, U4.6 (VCC), U5.1 (VDD), U6.8 (VDD)
3V3_SWITCHED_LED: C13.1, L1.1, Q7.3 (D), R13.1, U3.5 (VIN)
3V3_T: J6.1, R26.1; also elsewhere on the board
+3V3: BZ1.1 (-), C8.1, C9.1, C25.1, D16.2 (A), D21.1 (K), D22.1 (K), J8.1, M1.1 (+), Q2.2 (S), Q6.1 (G), Q7.2 (S), R1.1, R5.1, R24.2, R25.2, SW1.3 (C), U1.3 (3V3)
+5V: C1.1, D18.2 (A2), D24.1 (K), R6.1, U2.4 (VIN)
AUX_LoRa: U1.19 (IO5), U4.5 (AUX)
BTN_DOWN_B: J11.1, R20.2
BTN_DOWN_T: BTN3_DOWN1.1, J7.1
BTN_ENTER_B: J9.3, R19.2
BTN_ENTER_T: BTN1_ENTER1.1, J5.3
BTN_LEFT_B: J11.4, R21.1
BTN_LEFT_T: BTN5_LEFT1.1, J7.4
BTN_RIGHT_B: J9.2, R23.2
BTN_RIGHT_T: BTN4_RIGHT1.1, J5.2
BTN_UP_B: J9.1, R22.2
BTN_UP_T: BTN2_UP1.1, J5.1
CHANGE: U1.12 (IO0), U5.5 (~CHANGE/OUT4)
D+: D19.2 (A2), J1.A6 (D+), J1.B6 (D+), U1.27 (IO19)
D-: D20.2 (A2), J1.A7 (D-), J1.B7 (D-), U1.26 (IO18)
DATA_LED: J8.2, U1.16 (IO10)
DATA_LED_SIDE: R28.1, U1.6 (IO3)
DATA_LED_T: J6.2; also elsewhere on the board
GND: BT1.2 (-), C1.2, C2.2, C3.2, C4.2, C5.2, C6.2, C7.2, C8.2, C9.2, C10.2, C13.2, C14.2, C26.2, D18.1 (A1), D19.1 (A1), D20.1 (A1), J1.A1 (GND), J1.A12 (GND), J1.B1 (GND), J1.B12 (GND), J2.1, J3.1, J4.1, J8.5, J8.6, J11.2, J11.3, Q3.2 (S), Q4.2 (S), R2.2, R3.2, R7.2, R8.2, R10.2, R12.2, R14.2, R15.2, R29.2, U1.1 (GND), U1.2 (GND), U1.11 (GND), U1.14 (GND), U1.36 (GND), U1.37 (GND), U1.38 (GND), U1.39 (GND), U1.40 (GND), U1.41 (GND), U1.42 (GND), U1.43 (GND), U1.44 (GND), U1.45 (GND), U1.46 (GND), U1.47 (GND), U1.48 (GND), U1.49 (EPAD), U1.50 (GND), U1.51 (GND), U1.52 (GND), U1.53 (GND), U2.1 (TEMP), U2.3 (GND), U3.2 (GND), U4.7 (GND), U4.8 (GND), U4.9 (GND), U4.10 (GND), U5.2 (MODE), U5.14 (VSS), U6.4 (VSS)
GND_T: J6.5, J6.6, J7.2, J7.3, R27.2; also elsewhere on the board
GUARD_B: J9.4, R30.2
GUARD_T: J5.4, TP1.1
LED_1: D15.2 (A), J13.1
M0_LoRa: U4.1 (M0), U6.2 (IO1)
M1_LoRa: U4.2 (M1), U6.1 (IO0)
MOTOR: J13.2, U1.20 (IO6)
MOTOR_1: J13.3, Q4.1 (G), R15.1
unnamed: BT1.1 (+), C10.1, SW1.2 (B), U2.5 (BAT), U2.8 (FB)
unnamed: BZ1.2 (+), D21.2 (A), Q3.3 (D)
unnamed: C2.1, J2.2, R5.2, U1.8 (EN)
unnamed: C25.2, D22.2 (A), M1.2 (-), Q4.3 (D)
unnamed: D13.1 (K), U2.6 (/DONE)
unnamed: D13.2 (A), D14.2 (A), R6.2
unnamed: D14.1 (K), U2.7 (/CHRG)
unnamed: D15.1 (K), R29.1
unnamed: D16.1 (K), R12.1
unnamed: D17.2 (A), L1.2, U3.1 (SW)
unnamed: D24.2 (A), J1.A4 (VBUS), J1.A9 (VBUS), J1.B4 (VBUS), J1.B9 (VBUS)
unnamed: J1.A5 (CC1), R2.1
unnamed: J1.B5 (CC2), R3.1
unnamed: J3.3, Q6.3 (D), R11.2
unnamed: Q2.1 (G), R25.1, U1.5 (IO2)
unnamed: Q5.1 (C), R26.2
unnamed: Q6.2 (S), R28.2
unnamed: Q7.1 (G), R24.1, U6.3 (IO2)
unnamed: R8.1, U2.2 (ISET)
unnamed: R9.2, R10.1, U3.3 (FB)
unnamed: R13.2, U3.4 (/SHDN)
unnamed: R16.2, U5.4 (~RESET)
unnamed: R19.1, U5.12 (KEY1)
unnamed: R20.1, U5.10 (KEY3)
unnamed: R21.2, U5.8 (OUT1/KEY5)
unnamed: R22.1, U5.11 (KEY2)
unnamed: R23.1, U5.9 (KEY4)
unnamed: R30.1, U5.13 (KEY0)
PHOTOTRANZISTOR_B: J8.3, U1.13 (IO1)
PHOTOTRANZISTOR_T: J6.3, Q5.2 (E), R27.1
PIEZO: Q3.1 (G), R14.1, U1.21 (IO7)
PWR_LED: C14.1, D17.1 (K), J3.2, J8.4, R9.1, R11.1
PWR_LED_T: J6.4; also elsewhere on the board
RX_LoRa: J4.3, U1.31 (TXD0), U4.3 (RXD)
SCL: R18.2, U1.22 (IO8), U5.6 (SCL/OUT3), U6.6 (SCL)
SDA: R17.2, U1.23 (IO9), U5.3 (SDA/OUT0), U6.7 (SDA)
TX_LoRa: J4.2, U1.30 (RXD0), U4.4 (TXD)
U_BAT_ADC: R1.2, R7.1, U1.18 (IO4)

Notes on the sheet:
LiFePO4 max 3,6 V

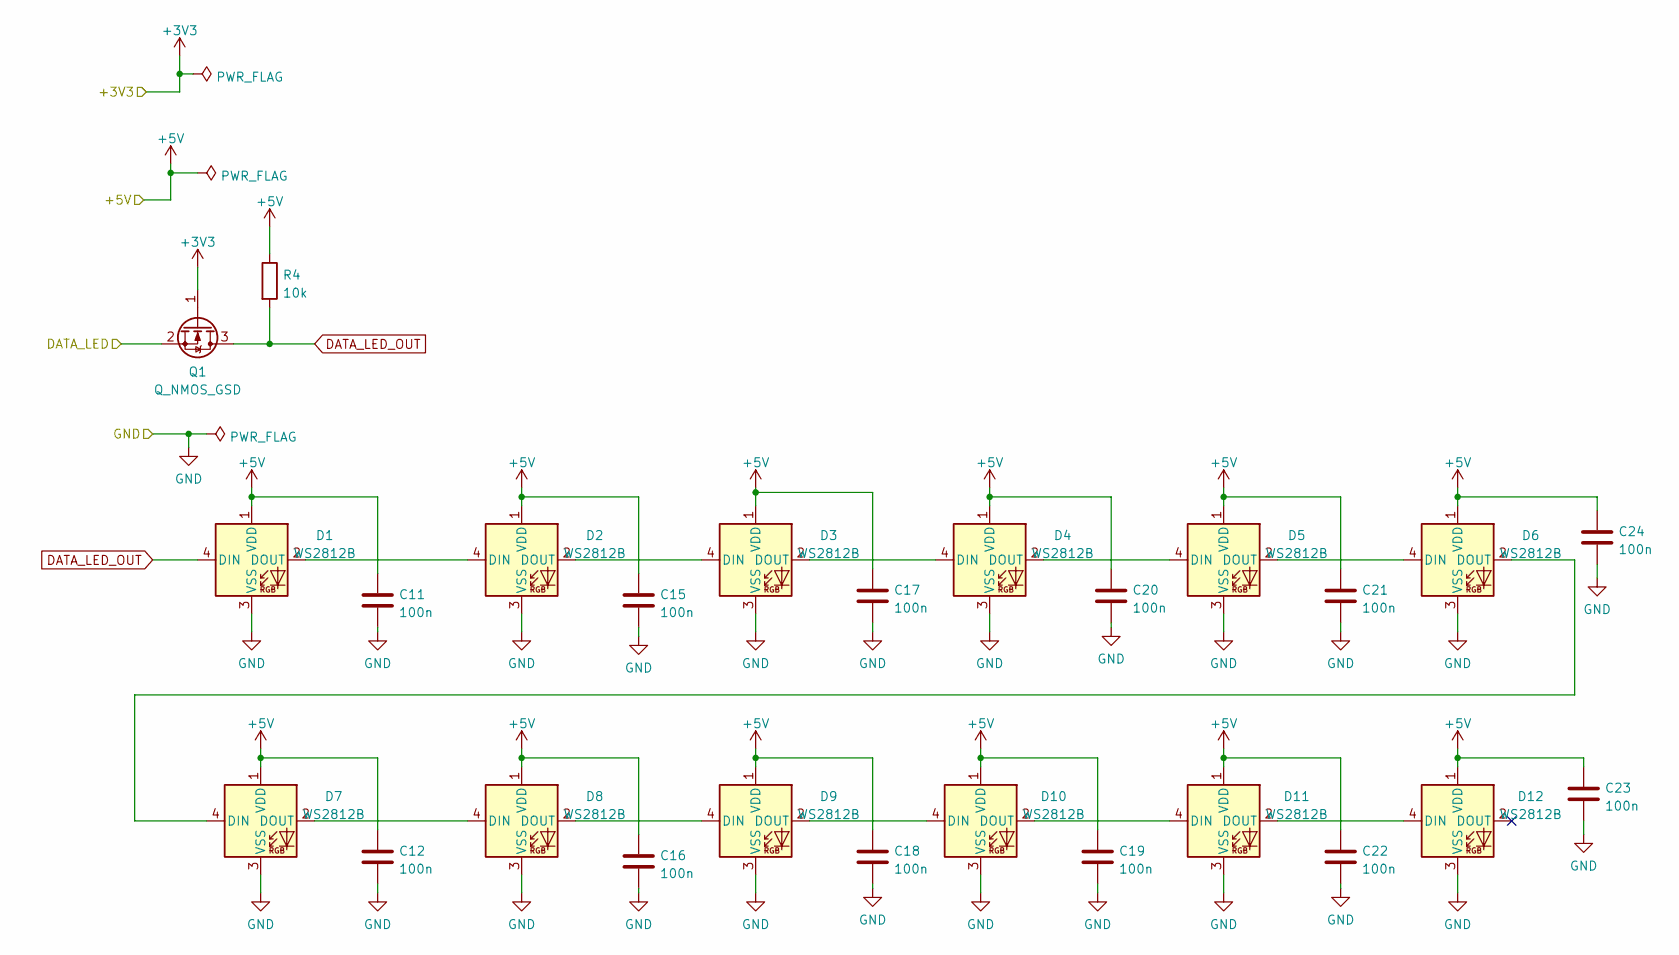
[picture p97: schematic LEDs.kicad_sch, WS2812C]

Parts:
C11, C12, C15, C16, C17, C18, C19, C20, C21, C22, C23, C24: 100n; C_0603_1608Metric; LCSC C14663
D1, D2, D3, D4, D5, D6, D7, D8, D9, D10, D11, D12: WS2812B; LED_WS2812B_PLCC4_5.0x5.0mm_P3.2mm; LCSC C2761796
Q1: Q_NMOS_GSD; SOT-23; LCSC C8545
R4: 10k; R_0603_1608Metric; LCSC C25804

Connections:
3V3_T: Q1.1 (G); also elsewhere on the board
DATA_LED_OUT: D1.4 (DIN), Q1.3 (D), R4.2
DATA_LED_T: Q1.2 (S); also elsewhere on the board
GND_T: C11.2, C12.2, C15.2, C16.2, C17.2, C18.2, C19.2, C20.2, C21.2, C22.2, C23.2, C24.2, D1.3 (VSS), D2.3 (VSS), D3.3 (VSS), D4.3 (VSS), D5.3 (VSS), D6.3 (VSS), D7.3 (VSS), D8.3 (VSS), D9.3 (VSS), D10.3 (VSS), D11.3 (VSS), D12.3 (VSS); also elsewhere on the board
unnamed: D1.2 (DOUT), D2.4 (DIN)
unnamed: D2.2 (DOUT), D3.4 (DIN)
unnamed: D3.2 (DOUT), D4.4 (DIN)
unnamed: D4.2 (DOUT), D5.4 (DIN)
unnamed: D5.2 (DOUT), D6.4 (DIN)
unnamed: D6.2 (DOUT), D7.4 (DIN)
unnamed: D7.2 (DOUT), D8.4 (DIN)
unnamed: D8.2 (DOUT), D9.4 (DIN)
unnamed: D10.2 (DOUT), D11.4 (DIN)
unnamed: D9.2 (DOUT), D10.4 (DIN)
unnamed: D11.2 (DOUT), D12.4 (DIN)
PWR_LED_T: C11.1, C12.1, C15.1, C16.1, C17.1, C18.1, C19.1, C20.1, C21.1, C22.1, C23.1, C24.1, D1.1 (VDD), D2.1 (VDD), D3.1 (VDD), D4.1 (VDD), D5.1 (VDD), D6.1 (VDD), D7.1 (VDD), D8.1 (VDD), D9.1 (VDD), D10.1 (VDD), D11.1 (VDD), D12.1 (VDD), R4.1; also elsewhere on the board

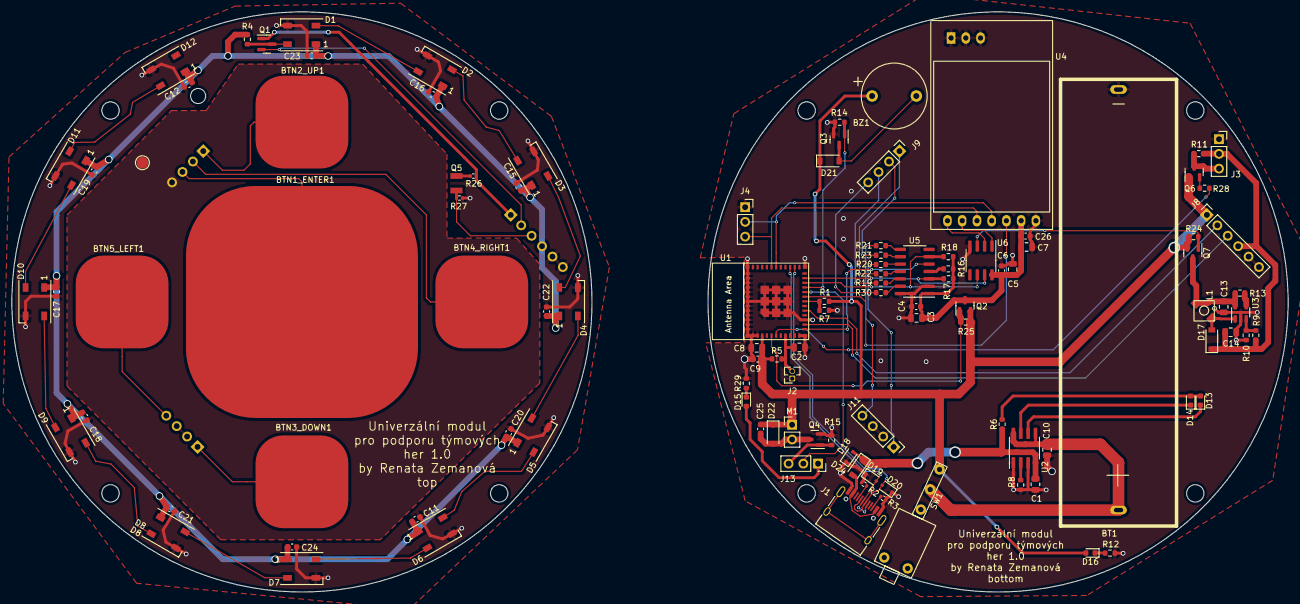
[picture p98: board Semafor.kicad_pcb from above]

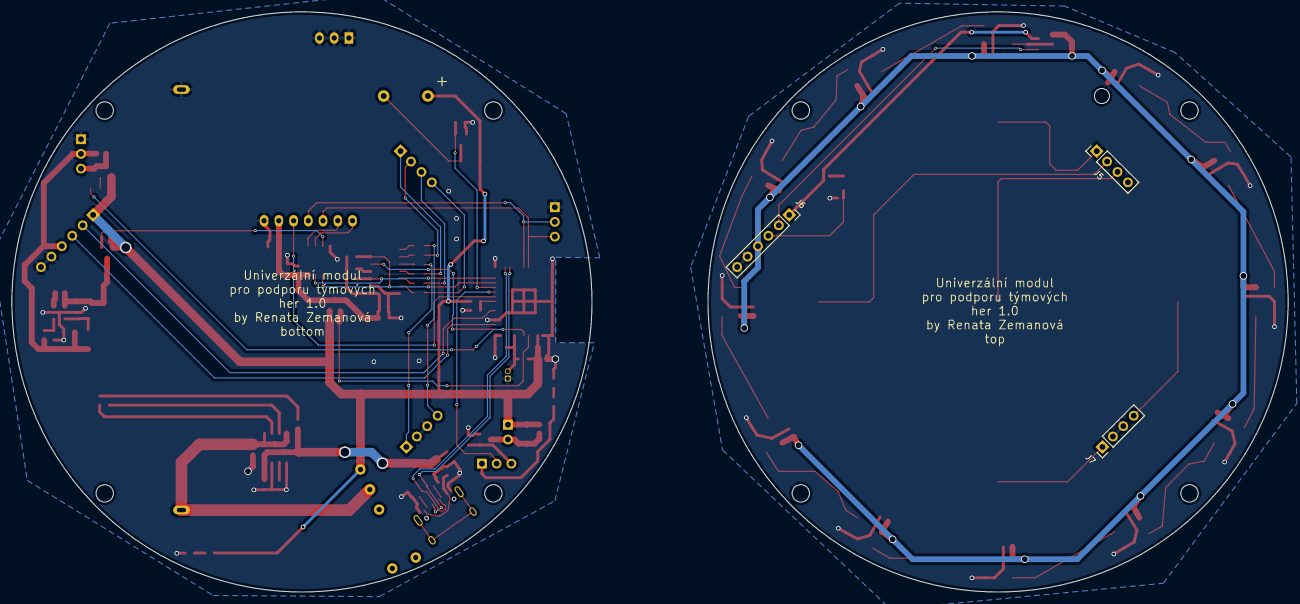
[picture p99: board Semafor.kicad_pcb from below]

Board: 2 copper layers, 220.0 x 100.0 mm, 114 parts (3 on the bottom side), 81 nets.
