renata7zemanova/Semafor/(commit log)

2022-10-27 add new symbol and package of ESP32-C3
2022-10-27 add footprint of battery dock
2022-10-27 start drawing schematic and PCB - LEDs, buttons, battery dock, ESP32-C3
    [BUTTONs.kicad_sch, LEDs.kicad_sch, Semafor.kicad_pcb, Semafor.kicad_sch]
2022-11-02 start writing, describing the selection of parts of the circuit
2022-11-02 add symbol of step up LT1930
    [LEDs.kicad_sch]
2022-11-02 schematic with MCU, USB-C, LEDs, buttons, level shifter and step up
    [Semafor.kicad_pcb]
2022-11-02 add text about charger and some comments
2022-11-02 add peripherial for ESP32-C3, add temporary package of switch and inductor, add package of MOS
    [LEDs.kicad_sch, Semafor.kicad_sch]
2022-11-02 basic placing units
    [Semafor.kicad_pcb]
2022-11-03 change package of inductor + add LSCS code
    [Semafor.kicad_sch]
2022-11-07 change value of inductor, update PCB, repair connection step up of pin /SHDN, delete capacitors from ESP32
    [Semafor.kicad_pcb, Semafor.kicad_sch]
2022-11-07 update symbol of LoRa module
    [Semafor.kicad_sch]
2022-11-07 update symbol ESP32-C3, add capacitors to WS2812C, add transils to USB
    [LEDs.kicad_sch, Semafor.kicad_pcb, Semafor.kicad_sch]
2022-11-08 add piezo, vibration motor
    [Semafor.kicad_sch]
2022-11-08 add USB_plug
    [Semafor.kicad_pcb, Semafor.kicad_sch]
2022-11-09 update footprint of battery dock
    [Semafor.kicad_pcb]
2022-11-09 add capacitive touch buttons and converter AT42QT1070
    [BUTTONs.kicad_sch, Semafor.kicad_pcb, Semafor.kicad_sch]
2022-11-09 update footprints of capacitive touch buttons, PCB
    place capacitive buttons, LEDs, LoRa module, battery pack
    [Semafor.kicad_pcb, Semafor.kicad_sch]
2022-11-09 add text about vibrate motor, converter for capacitive touch buttons AT42QT1070
2022-11-09 add some datasheets, add diodes to USBs
    [Semafor.kicad_pcb, Semafor.kicad_sch]
2022-11-12 text about PCB - capacitive buttons, LEDs WS2812C, wireless communication
2022-11-17 change datasheet WS2812C, add datasheet LT1930, repair voltage on pin FB of LT1930
    [LEDs.kicad_sch, Semafor.kicad_sch]
2022-11-19 routing PCB - LEDs
    [LEDs.kicad_sch, Semafor.kicad_pcb, Semafor.kicad_sch]
2022-11-19 text about charger, buttons
2022-11-19 add text about buttons
2022-12-28 add fill of description field
    [LEDs.kicad_sch, Semafor.kicad_pcb, Semafor.kicad_sch]
2022-12-30 add voltage reference
    [Semafor.kicad_pcb, Semafor.kicad_sch]
2022-12-30 add text about microcontroler, delete introduction, add some shortcuts, delete some attachments
2022-12-31 add final block diagram, add text about power LED and sound signalization
2022-12-31 add datasheet, change engagement at CN3058E of TEMP
    [Semafor.kicad_sch]
2023-01-01 repair text I2C, add text about bettery charger, add new title pages
2023-01-01 add text about diode, inductor and piezo, delete text about PCB
2023-01-01 repair shottky diodes
    [Semafor.kicad_sch]
2023-01-02 add text about shottky diodes, add block diagram of MCU and text about MCU, update pdf with task, repair mistakes and add some text to introduction and conclusion
2023-01-02 repair mistakes in schematic, add switched supply voltage to LoRa, LEDs and converter for capacitive buttons
    [LEDs.kicad_sch, Semafor.kicad_pcb, Semafor.kicad_sch]
2023-01-02 add images, repair some images, add side dishes, delete mistakes in charge module
2023-01-03 update PCB
    [Semafor.kicad_pcb]
2023-01-18 repair ERC errors
    [LEDs.kicad_sch, Semafor.kicad_pcb, Semafor.kicad_sch]
2023-01-18 routing ESP and charger
    [Semafor.kicad_pcb]
2023-02-03 routing done
    [Semafor.kicad_pcb]
2023-02-03 add some codes for assembly byJLCPCB
    [LEDs.kicad_sch, Semafor.kicad_pcb, Semafor.kicad_sch]
2023-02-05 add title of PCB
    [Semafor.kicad_pcb]
2023-02-05 add LCSC codes for assembly
    [Semafor.kicad_sch]
2023-02-06 repair fill zones
    [Semafor-CmtUser.gbr, Semafor-CuBottom.gbl, Semafor-CuTop.gtl, Semafor-EdgeCuts.gm1, Semafor-MaskBottom.gbs, Semafor-MaskTop.gts, Semafor-PasteBottom.gbp, Semafor-PasteTop.gtp]
2023-02-06 add fabrication files
    [Semafor-CmtUser.gbr, Semafor-CuBottom.gbl, Semafor-CuTop.gtl, Semafor-EdgeCuts.gm1, Semafor-MaskBottom.gbs, Semafor-MaskTop.gts, Semafor-PasteBottom.gbp, Semafor-PasteTop.gtp]
2023-02-06 reduction dimensions of PCB + routing, update fabrication files
    [Semafor-CmtUser.gbr, Semafor-CuBottom.gbl, Semafor-CuTop.gtl, Semafor-EdgeCuts.gm1, Semafor-MaskBottom.gbs, Semafor-MaskTop.gts, Semafor-PasteBottom.gbp, Semafor-PasteTop.gtp]
2023-02-15 make folder for HW v0.0
    [BUTTONs.kicad_sch, LEDs.kicad_sch, Semafor.kicad_pcb, Semafor.kicad_sch]
2023-02-27 functions for LEDs
2023-02-28 add functions for battery and button
2023-03-01 add function for motor, piezo, delete old functions for capacitive buttons, change structure and using structure for LED
2023-03-07 preparing form for silicone transparent cover
    [forma.SLDASM, predni_cast.SLDPRT, zadni_cast.SLDPRT]
2023-03-16 repair mistake with LoRa and change board on ESP32-C3
    [lib.h]
2023-03-17 add text about LoRa and PCB
2023-03-27 sw for testing prototype PCB
2023-03-30 add text about testing prototype PCB
2023-04-05 create my library for chip for capacitive buttons AT42QT1070
2023-04-11 text about testing capacitive buttons and chip AT42QT1070
2023-04-12 repair mistakes from prototype PCB
    [Semafor.kicad_pcb, Semafor.kicad_sch]
2023-04-12 add phototransistor and connector for programmable LEDs (on side)
    [Semafor.kicad_pcb, Semafor.kicad_sch]
2023-04-18 start drawing small version of Module, draw stepup as per datasheet
    [Semafor.kicad_pcb, Semafor.kicad_sch]
2023-04-18 continue routing
    [LEDs.kicad_sch, Semafor.kicad_pcb, Semafor.kicad_sch]
2023-04-19 done routing of version 1.0
    [Semafor.kicad_pcb, Semafor.kicad_sch]
2023-04-20 charging LEDs place to PCB bottom
    [Semafor.kicad_pcb, Semafor.kicad_sch]
2023-04-20 touching buttons is certain with multitouch
2023-04-23 add text about soldering, FW - AT42QT1070, LEDs, battery
2023-04-23 add function toggle all LEDs
2023-04-24 repair mistakes and preparing for 2 PCBs (sandwich)
    [Semafor.kicad_pcb, Semafor.kicad_sch]
2023-04-24 routed top PCB (with buttons, LEDs and phototransistor)
    [LEDs.kicad_sch, Semafor.kicad_pcb, Semafor.kicad_sch]
2023-04-24 2 PCB version of Semafor done
    [LEDs.kicad_sch, Semafor.kicad_pcb, Semafor.kicad_sch]
2023-04-24 rotate Q2
    [Semafor.kicad_pcb]
2023-04-24 change some routing tracks
    [Semafor.kicad_pcb]
2023-04-24 replace labels
    [Semafor.kicad_pcb]
2023-04-25 repair vibration, delays to metronome, add ESP32-WROOM platform
    [lib.cpp, lib.h, main.cpp]
2023-04-26 add slide switch for power on, change guard zone around buttons
    [Semafor.kicad_pcb, Semafor.kicad_sch]
2023-04-26 add 3D models of my gadgets
    [Semafor.kicad_pcb]
2023-04-26 changes for better EMC, change thickness of tracks, change position of pinheads
    [Semafor.kicad_pcb, Semafor.kicad_sch]
2023-04-27 add thermals to top PCB, solve thombstoning
    [Semafor.kicad_pcb]
2023-04-27 save fab for v0.0, generate fab for v1.0
    [Semafor-CmtUser.gbr, Semafor-CuBottom.gbl, Semafor-CuTop.gtl, Semafor-EdgeCuts.gm1, Semafor-MaskBottom.gbs, Semafor-MaskTop.gts, Semafor-PasteBottom.gbp, Semafor-PasteTop.gtp]
2023-04-27 add via to step up output C
    [Semafor.kicad_pcb]
2023-04-27 add text about water resistance + user manual
2023-04-28 prepare separate boards for fab
    [Semafor_bottom.kicad_pcb, Semafor_top.kicad_pcb]
2023-04-28 generate fab for top and bottom PCB, delete fab for both of PCB together
    [Semafor-CuBottom.gbl, Semafor-CuTop.gtl, Semafor-EdgeCuts.gm1, Semafor-MaskBottom.gbs, Semafor-MaskTop.gts, Semafor-PasteTop.gtp, Semafor-SilkBottom.gbo, Semafor-SilkTop.gto]
2023-04-28 change positions of some parts on bottom PCB - prepare for fab
    [Semafor.kicad_sch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]
2023-04-28 create back-up of version 1.0
    [BUTTONs.kicad_sch, LEDs.kicad_sch, Semafor.kicad_pcb, Semafor.kicad_sch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]
2023-04-30 text about final version of PCB
2023-05-02 add 3D model of piezo
    [Semafor.kicad_pcb]
2023-05-03 add block schematic with FW, add text about silicone cover
2023-05-05 add model of silicone mould
    [Battery_pack.SLDPRT, Battery_pack.STEP, Button.SLDPRT, Celkova_forma_Semafor_2.SLDPRT, E22_900T22D.SLDPRT, E22_900T22D.STEP, Forma_sestava.SLDASM, Obal.SLDPRT]
2023-05-05 add some parts to new folder - "soucastky", add long pinheaders
    [Battery_pack.SLDPRT, Battery_pack.STEP, Button.SLDPRT, E22_900T22D.SLDPRT, E22_900T22D.STEP, Piezo.SLDPRT, Piezo.STEP, Pinheady_dlouhe.SLDPRT]
2023-05-05 change 3D parts .wrl to .step
    [Semafor_bottom.kicad_pcb, Semafor_top.kicad_pcb]
2023-05-07 add 3D model of power switch
    [Vypinac.SLDPRT, Vypinac.STEP]
2023-05-07 add 3d model of power switch to PCB
    [Semafor.kicad_sch, Semafor_bottom.kicad_pcb]
2023-05-07 make backup of v1.0 with 3D models of some parts
    [BUTTONs.kicad_sch, Semafor.kicad_sch, Semafor_bottom.kicad_pcb, Semafor_top.kicad_pcb]
2023-05-10 add photos of prototype PCB
2023-05-12 add attachments
2023-05-15 add 3D models of cover
    [Krabicka_3D_tisk.3MF, Krabicka_3D_tisk.SLDPRT, Krabicka_3D_tisk.STL, Na_tyblo.SLDPRT, Na_tyblo.STL, forma.SLDASM, predni_cast.SLDPRT, zadni_cast.SLDPRT]
2023-05-15 generate 3MF and STL of cover for printing
    [Krabicka_3D_tisk.3MF, Krabicka_3D_tisk.STL, Na_tyblo.3MF]
2023-05-16 working on phototransistor and battery measurement, sending settings is working
2023-05-16 text about cover and assembly
2023-05-16 update description field
    [Semafor.kicad_pcb, Semafor_bottom.kicad_pcb]
